impatrq/REDUX/Estructura/Soporte de pantalla/Vista_Isometrica.PNG

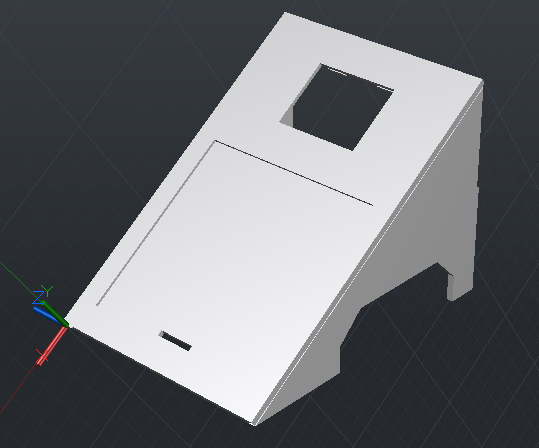
Estructura/Soporte de pantalla/Vista_Isometrica.PNG
