impatrq/REDUX/Kicad/Versión_1/README.md

Primer diseño de kicad de la amplificación y los filtros para sEMG.
