impatrq/REDUX/Circuitos/Filtros_EMG/High_Pass_20Hz/README.md

Diagrama de Bode y archivo LTSpice del filtro pasa-altos con una frecuencia de corte aproximada de 500Hz
