impatrq/REDUX/Circuitos/Filtros_EMG/Low_Pass_500Hz/README.md

Diagrama de Bode y archivo LTSpice del filtro pasa-bajos con una frecuencia de corte aproximada de 500Hz
