impatrq/REDUX/Circuitos/Rectificador_de_Precision/README.md

Se adjuntan los esquemticos del rectificador de precision junto a su simulacion en LTspice
