impatrq/REDUX/Circuitos/Filtros_EMG/High_Pass_20Hz/High_Pass_Wizard.png

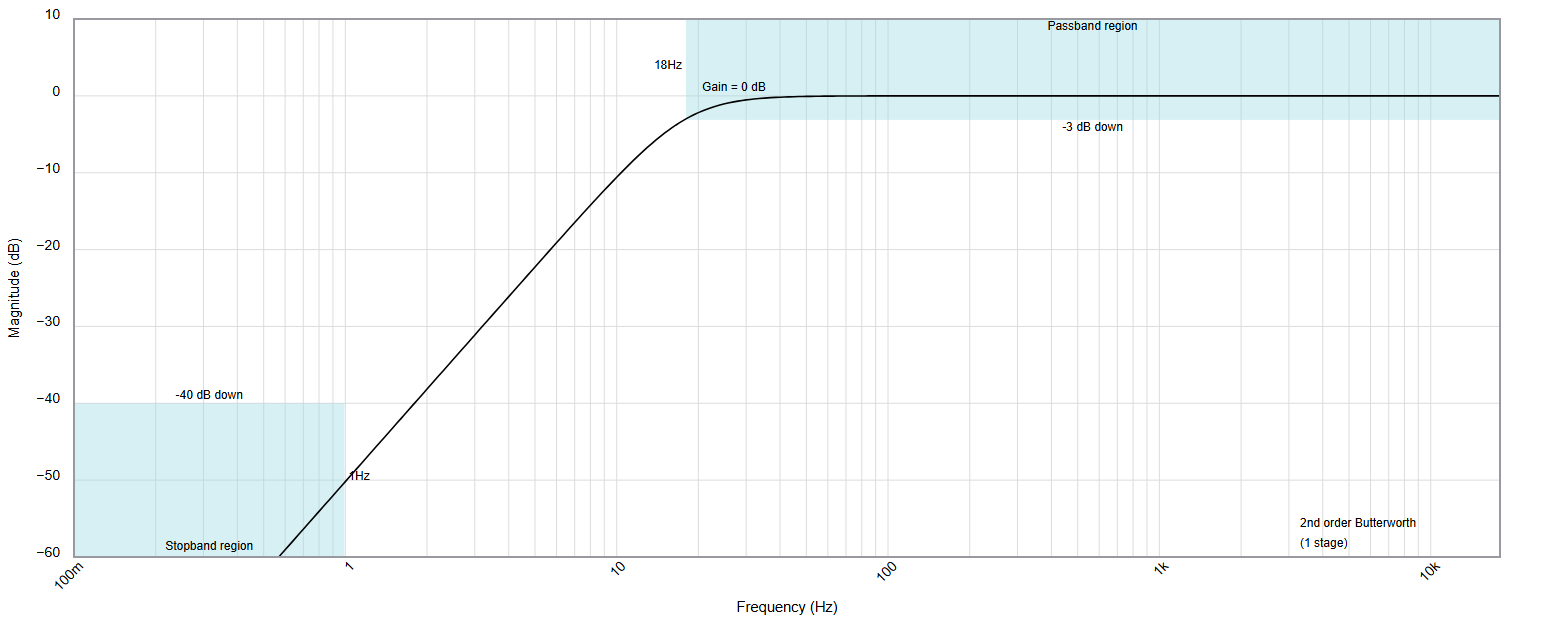
Circuitos/Filtros_EMG/High_Pass_20Hz/High_Pass_Wizard.png
