impatrq/REDUX/Circuitos/Filtros_EMG/High_Pass_20Hz/High_Pass_Zoom_LTSpice.png

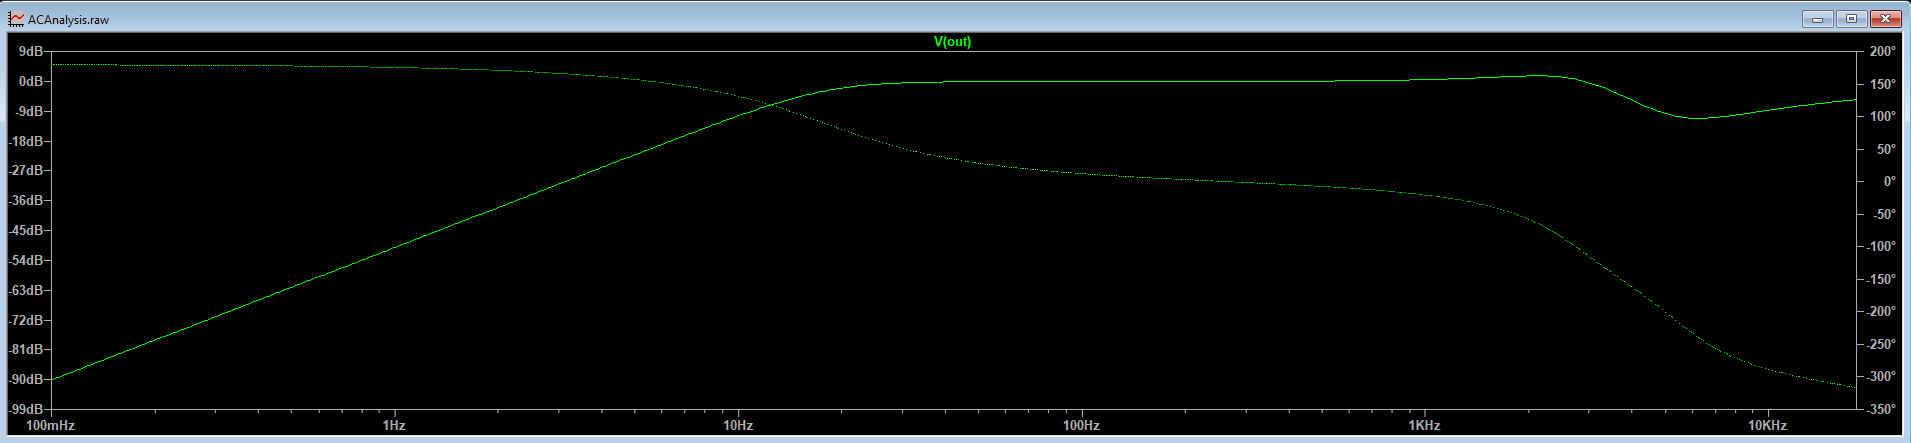
Circuitos/Filtros_EMG/High_Pass_20Hz/High_Pass_Zoom_LTSpice.png
