impatrq/REDUX/Circuitos/Filtros_EMG/Low_Pass_500Hz/Low_Pass_Wizard.png

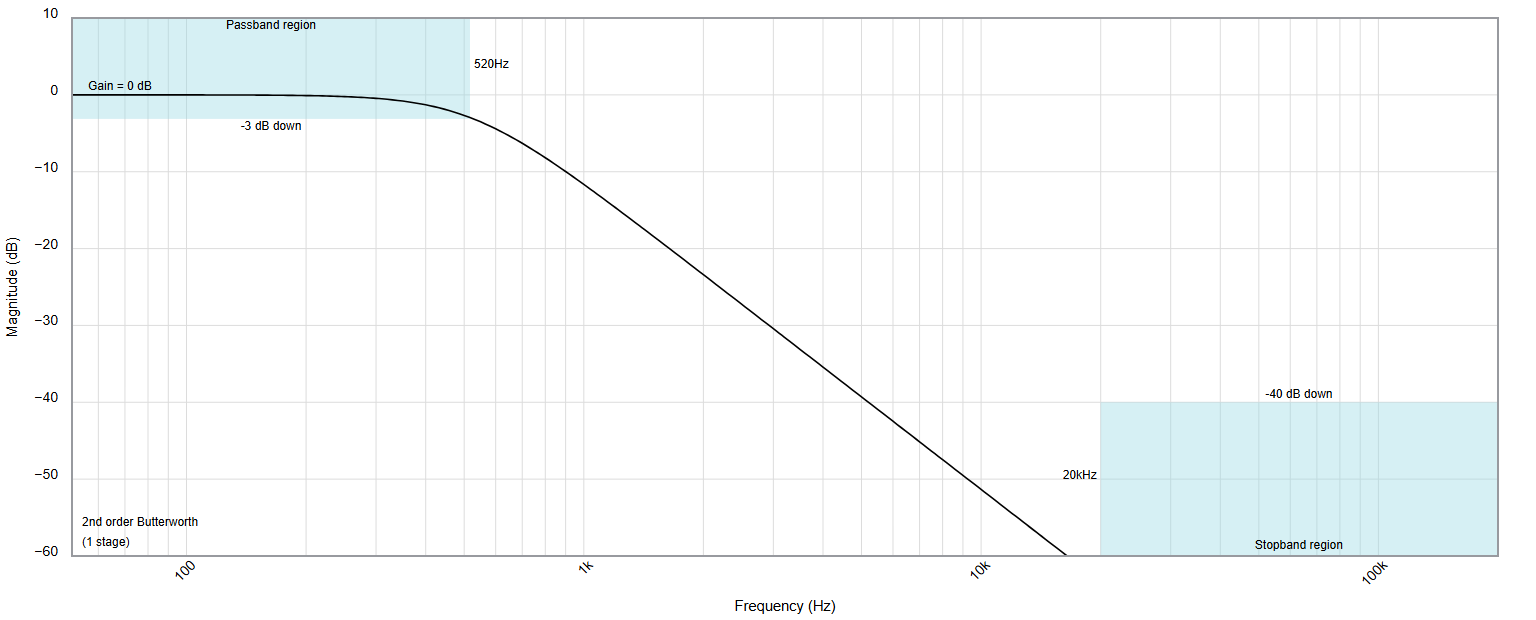
Circuitos/Filtros_EMG/Low_Pass_500Hz/Low_Pass_Wizard.png
