impatrq/REDUX/Circuitos/Filtros_EMG/Low_Pass_500Hz/Low_Pass_Zoom_LTSpice.png

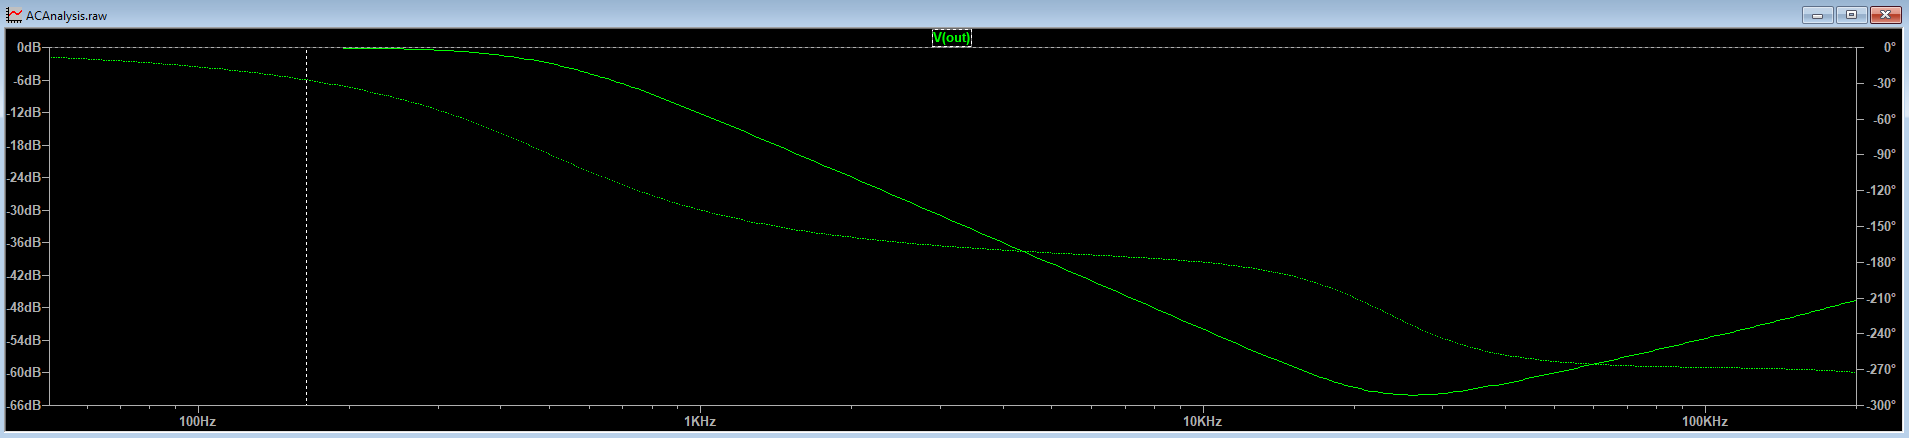
Circuitos/Filtros_EMG/Low_Pass_500Hz/Low_Pass_Zoom_LTSpice.png
