impatrq/REDUX/Circuitos/Rectificador_de_Precision/Onda-completa.png

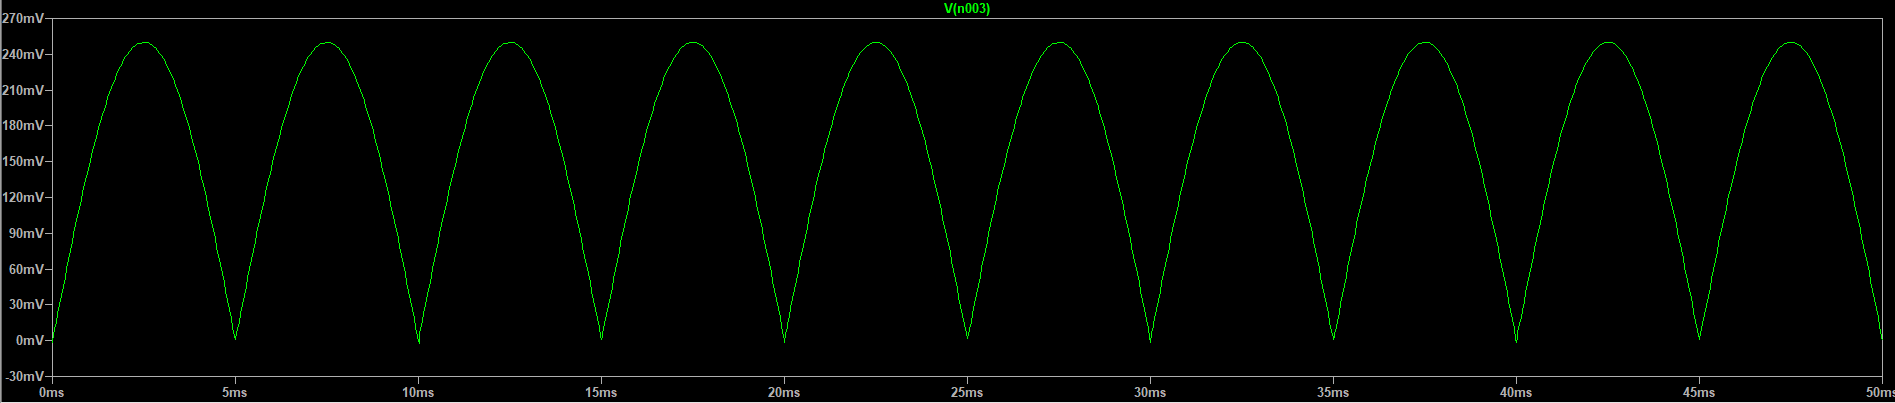
Circuitos/Rectificador_de_Precision/Onda-completa.png
