impatrq/REDUX/Circuitos/Rectificador_de_Precision/Rectificador-de-Precision.png

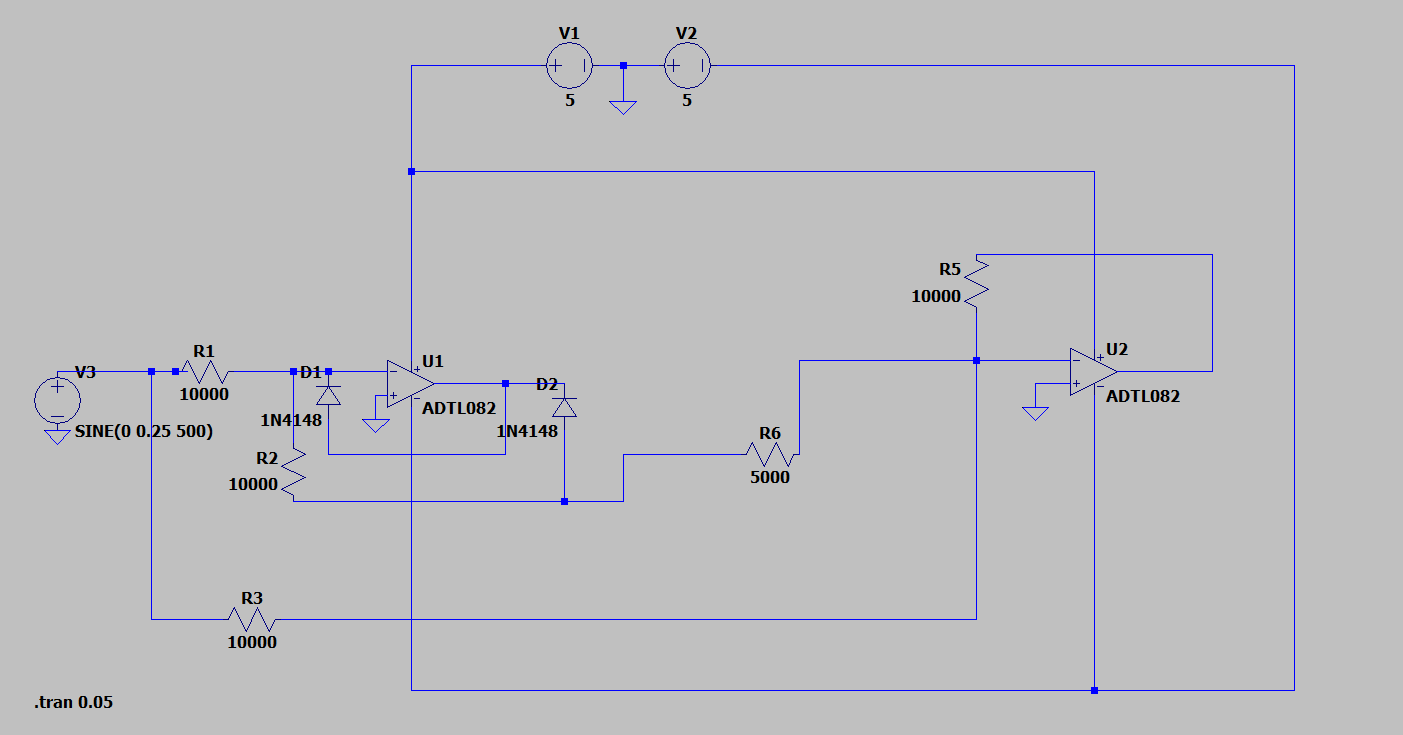
Circuitos/Rectificador_de_Precision/Rectificador-de-Precision.png
