impatrq/REDUX/Docs/AMEF.jpeg

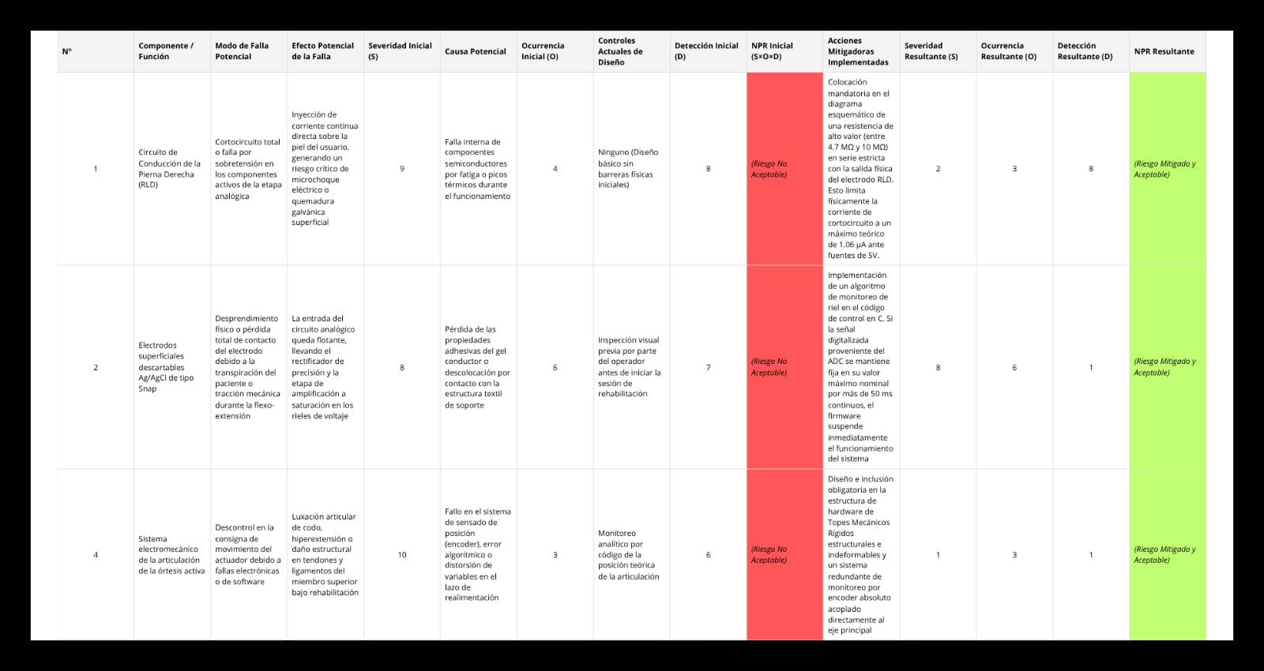
Docs/AMEF.jpeg
