impatrq/REDUX/Estructura/Sorporte de motor/Vista_Isometrica.PNG

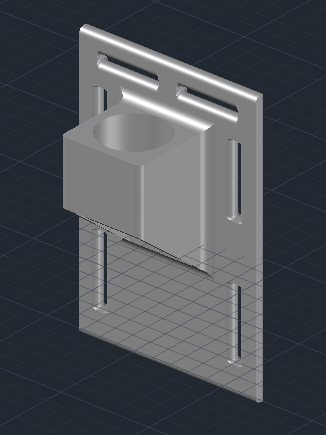
Estructura/Sorporte de motor/Vista_Isometrica.PNG
