impatrq/REDUX/Estructura/Vista_isometrica.png

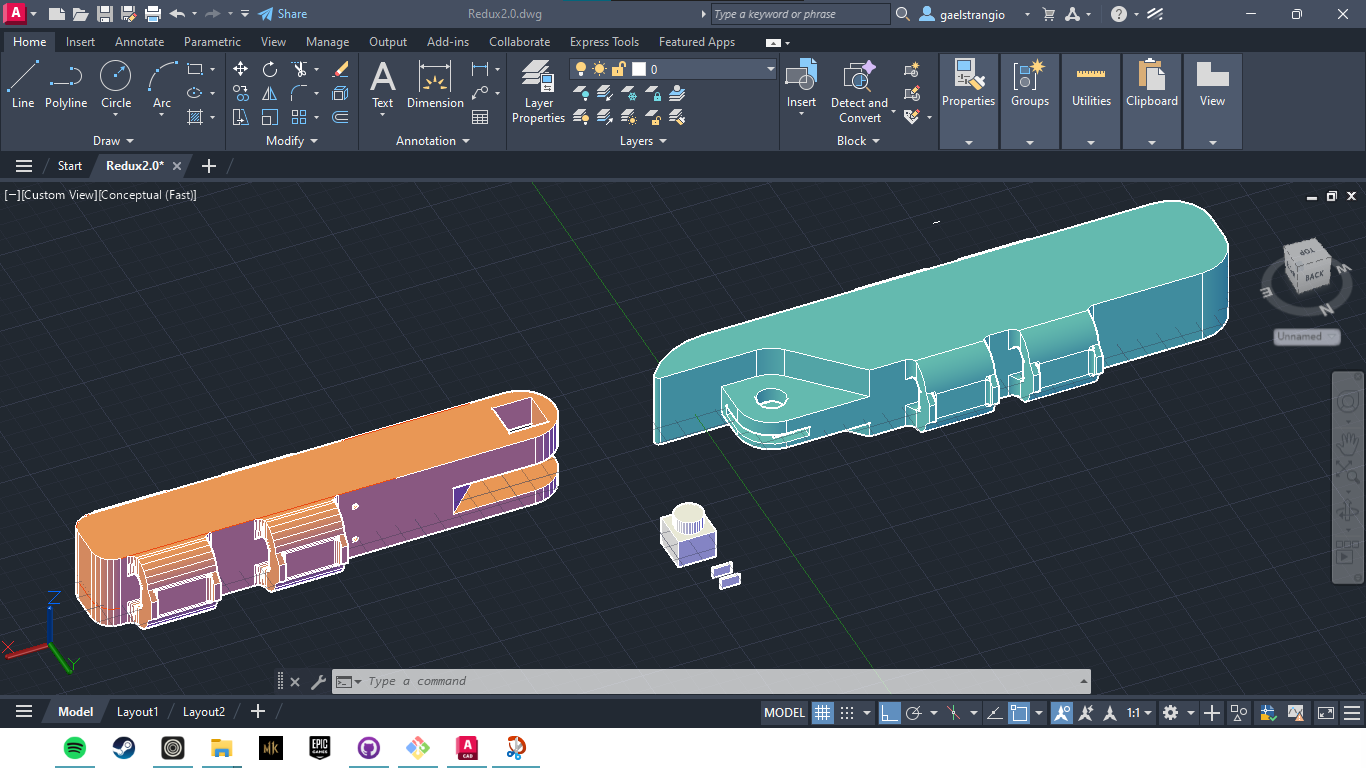
Estructura/Vista_isometrica.png
