impatrq/REDUX/Kicad/Versión_1/Diseño_3D.png

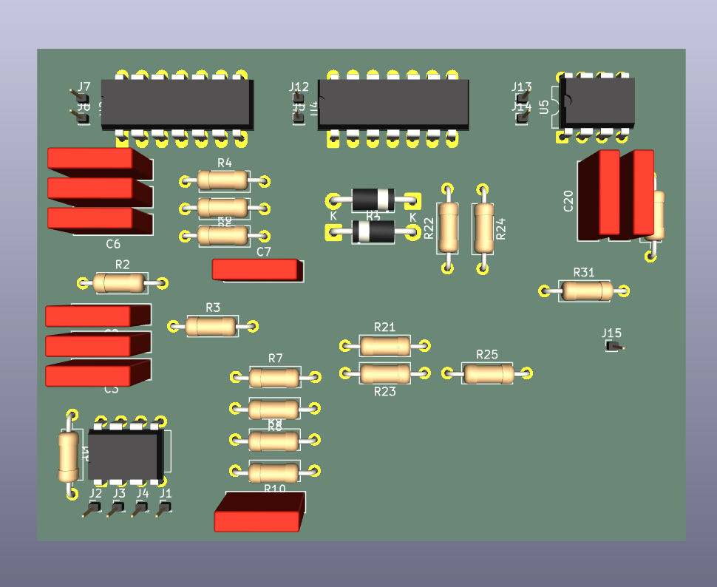
Kicad/Versión_1/Diseño_3D.png
