impatrq/REDUX/Kicad/Versión_1/Editor_de_placa.png

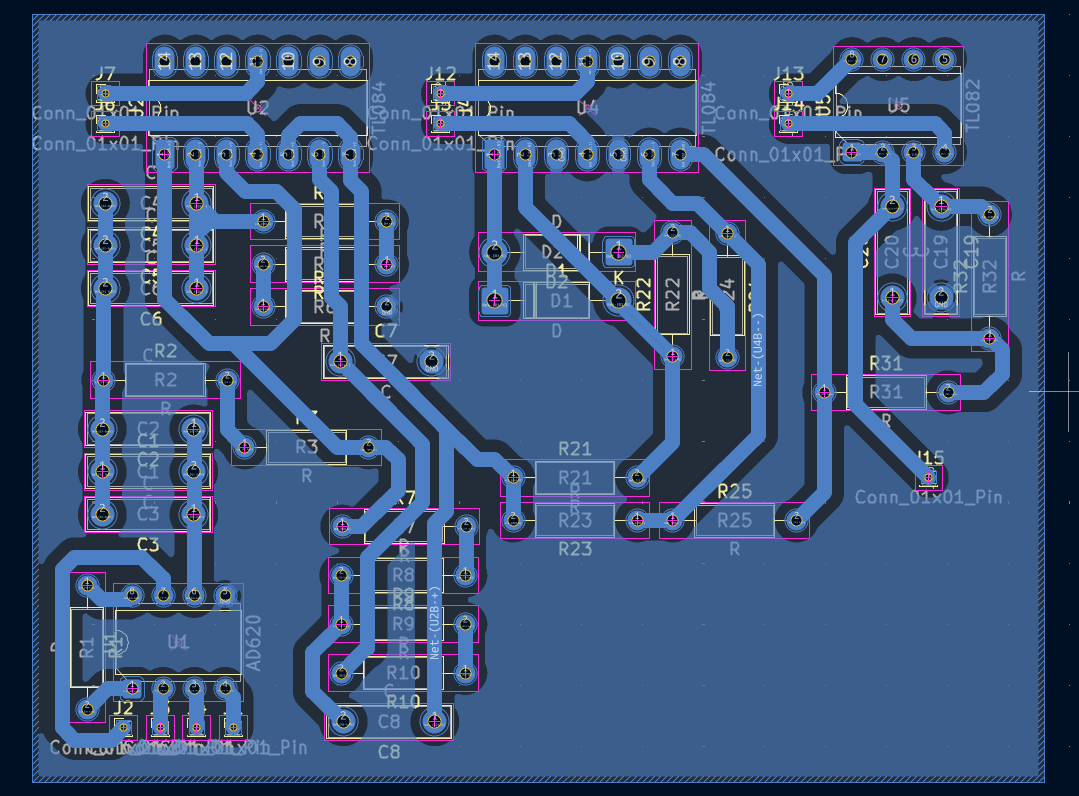
Kicad/Versión_1/Editor_de_placa.png
