impatrq/REDUX/Kicad/Versión_1/Filtro pasabajos.png

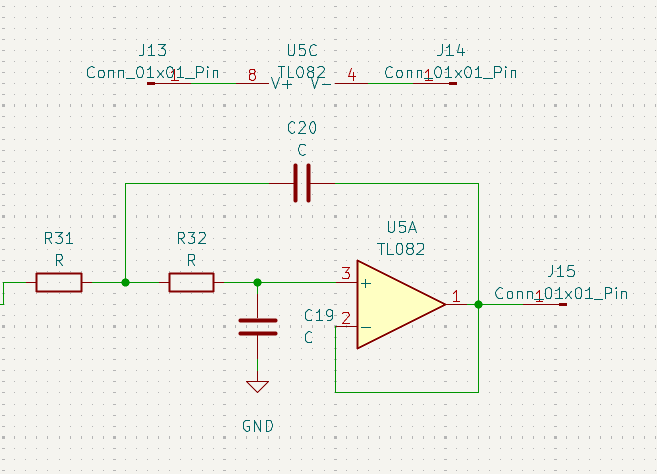
Kicad/Versión_1/Filtro pasabajos.png
