impatrq/REDUX/Kicad/Versión_1/Filtro pasabanda.png

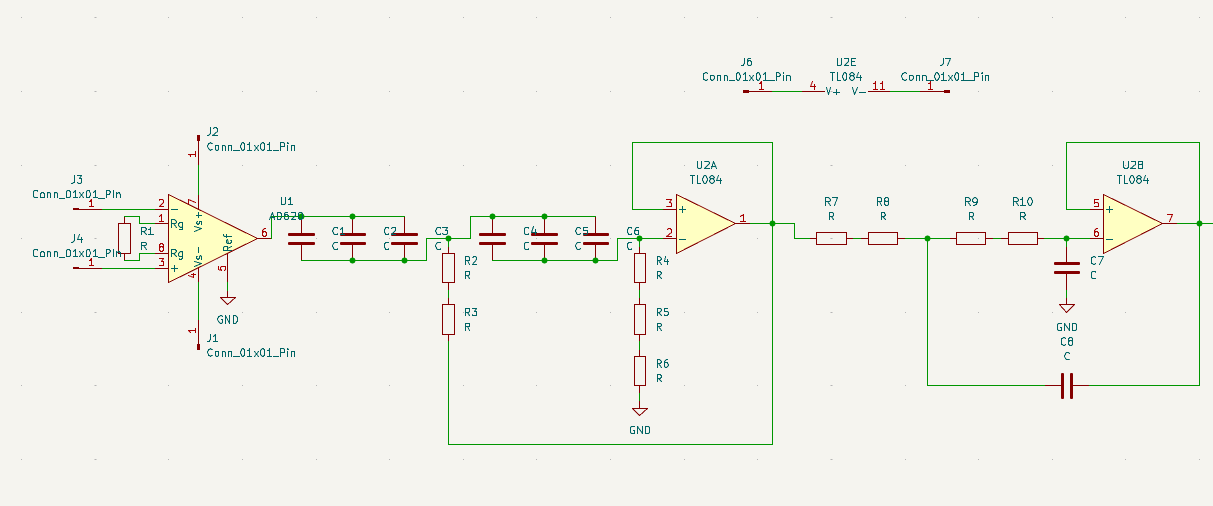
Kicad/Versión_1/Filtro pasabanda.png
