impatrq/REDUX/Kicad/Versión_1/Rectificador de precision.png

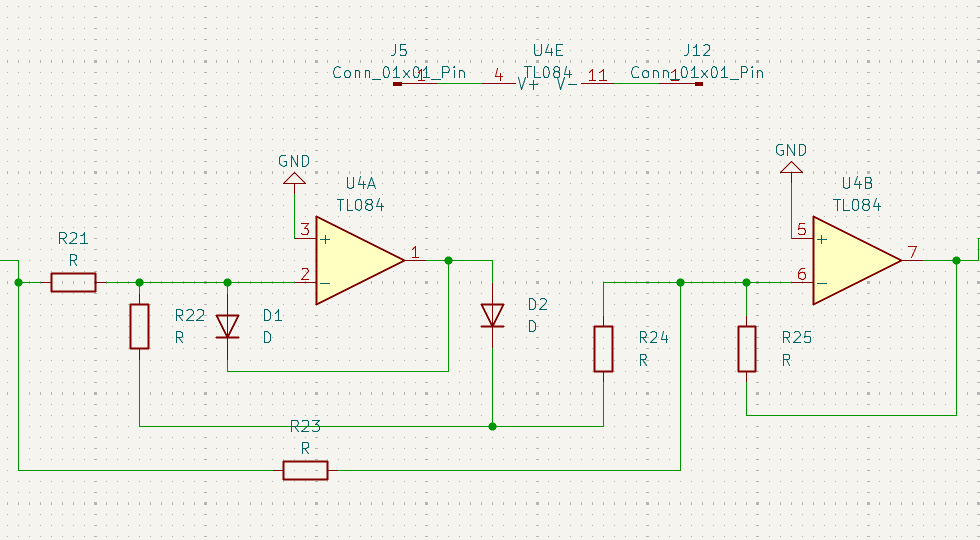
Kicad/Versión_1/Rectificador de precision.png
