impatrq/REDUX/Kicad/Versión_2/Etapa de filtro pasabajos/Etapa de filtro pasabajos_pcb.png

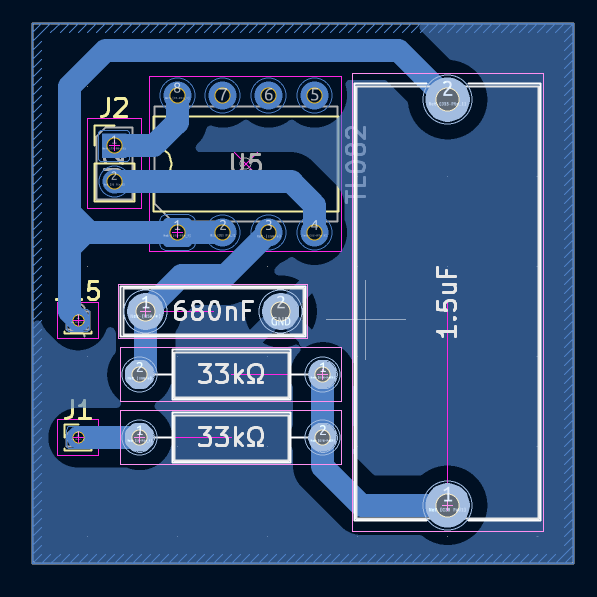
Kicad/Versión_2/Etapa de filtro pasabajos/Etapa de filtro pasabajos_pcb.png
