impatrq/REDUX/Kicad/Versión_2/Etapa de filtro pasabanda/Etapa de filtro pasabanda — Editor de placas 28_08_2026 14_08_09.png

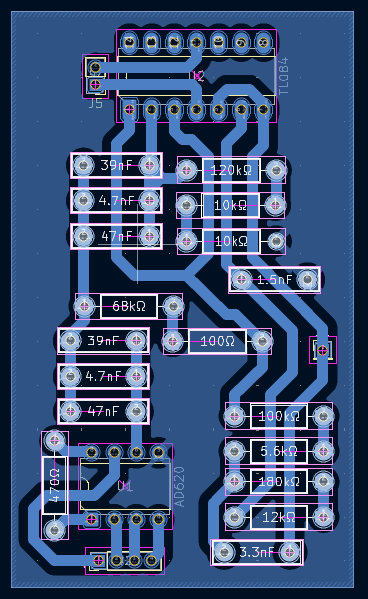
Kicad/Versión_2/Etapa de filtro pasabanda/Etapa de filtro pasabanda — Editor de placas 28_08_2026 14_08_09.png
