impatrq/REDUX/Kicad/Versión_2/Etapa de rectificación de presición/Etapa de rectificación de presición_pcb.png

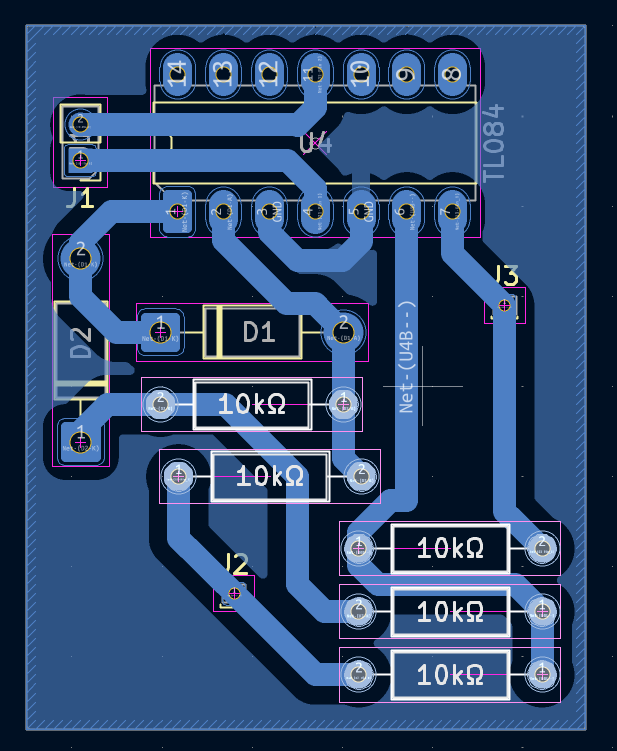
Kicad/Versión_2/Etapa de rectificación de presición/Etapa de rectificación de presición_pcb.png
