impatrq/REDUX/modelo_preeliminar/Vista_Frontal.png

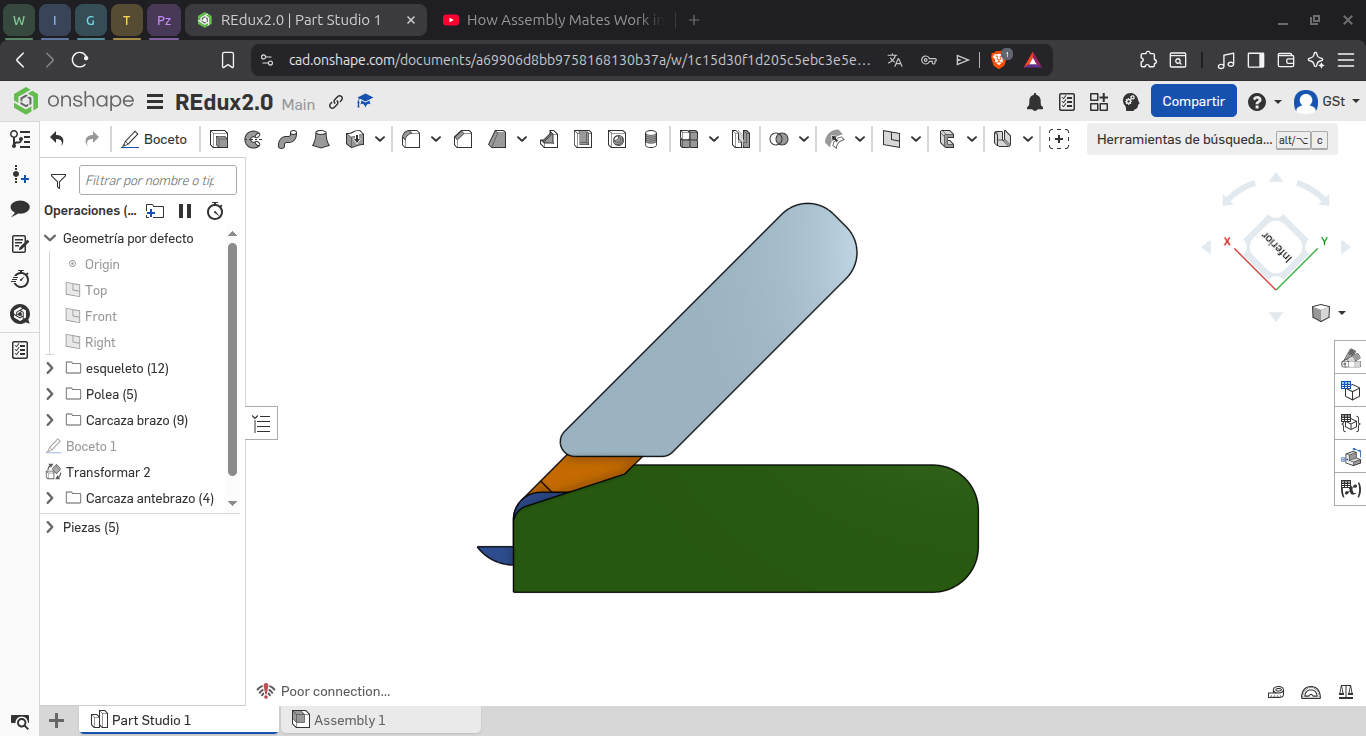
modelo_preeliminar/Vista_Frontal.png
