impatrq/REDUX/modelo_preeliminar/Vista_Isometrica.png

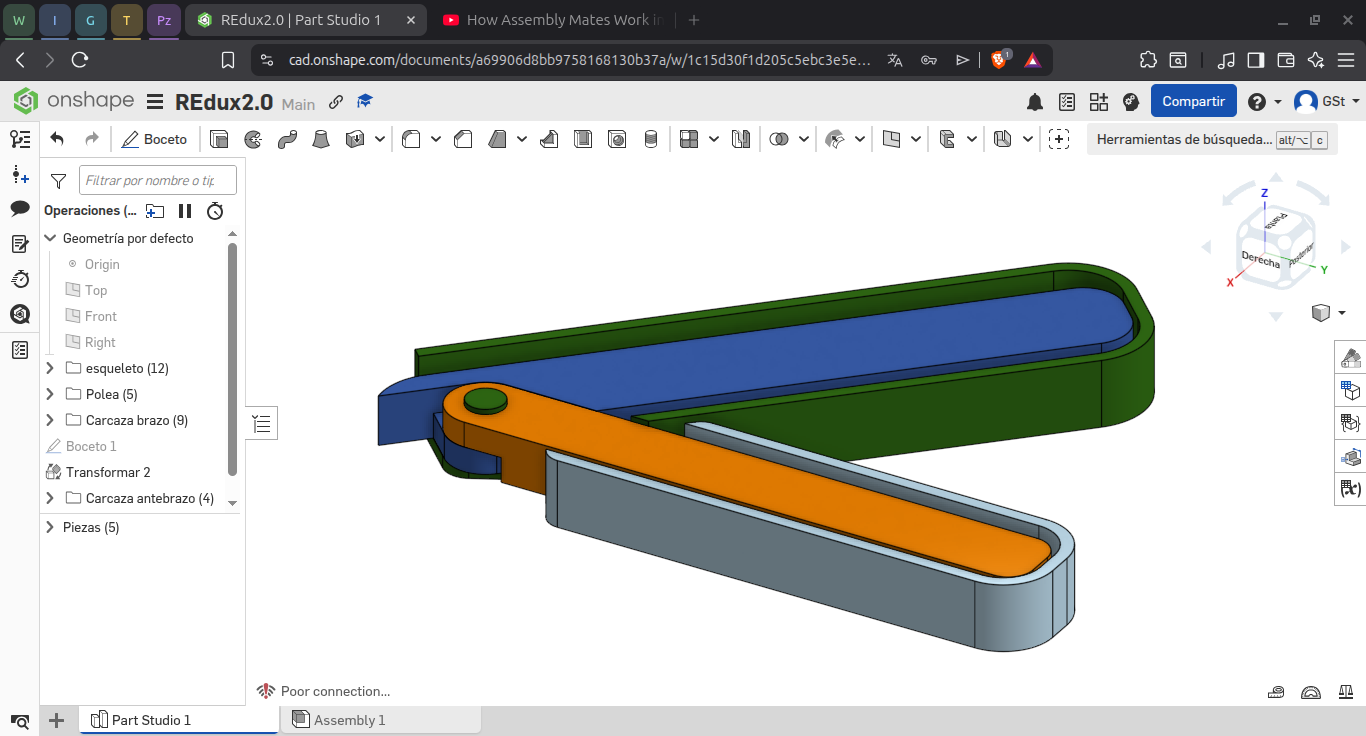
modelo_preeliminar/Vista_Isometrica.png
