impatrq/REDUX/modelo_preeliminar/Vista_Posterior.png

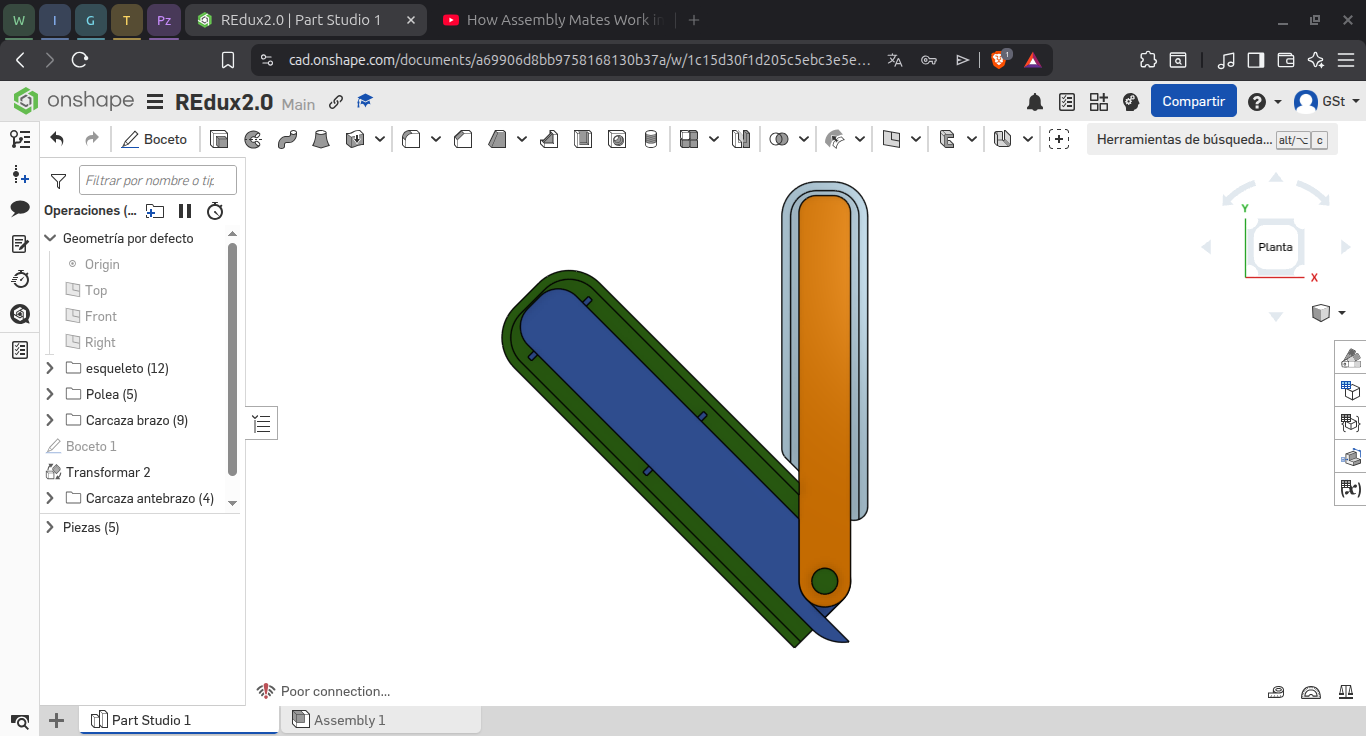
modelo_preeliminar/Vista_Posterior.png
