impatrq/REDUX/Estructura/Caja/tapa.stl

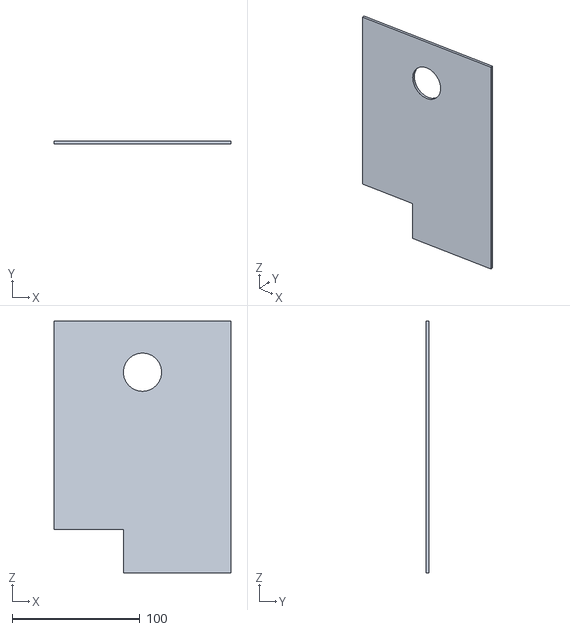
[picture p25: CAD file, 2026-11-13]
Estructura/Caja/tapa.stl
138.0 x 2.30 x 197.0
