impatrq/REDUX/Estructura/Redux_''final''_eje.stl

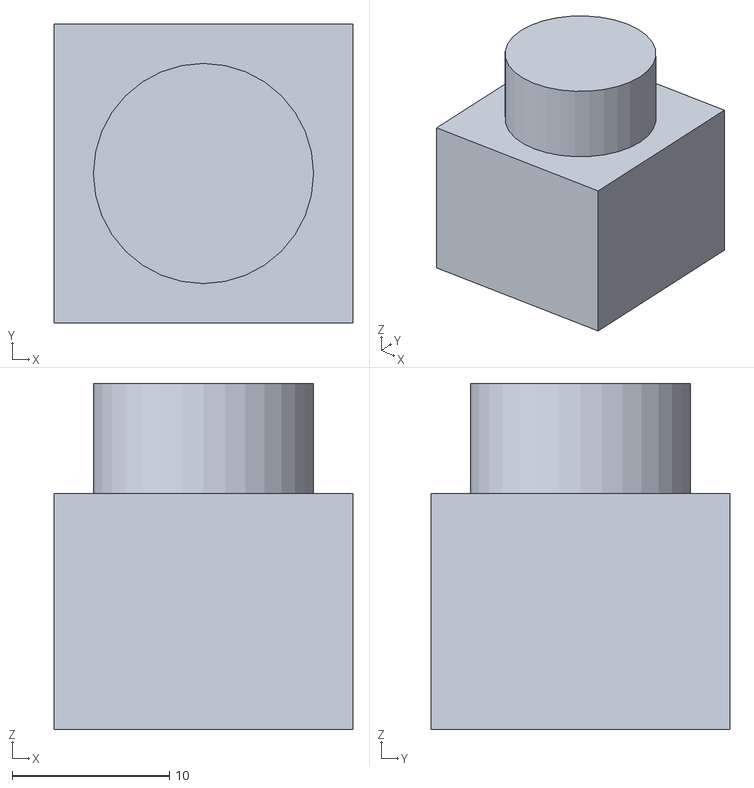
[picture p26: CAD file, 2026-08-31]
Estructura/Redux_''final''_eje.stl
19.0 x 19.0 x 22.0
