impatrq/REDUX/Estructura/Soporte de pantalla/Soporte_pantalla.stl

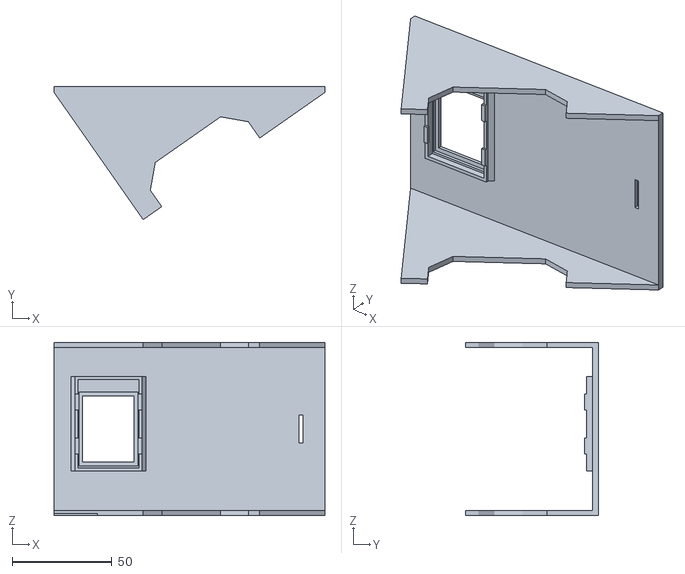
[picture p27: CAD file, 2026-10-20]
Estructura/Soporte de pantalla/Soporte_pantalla.stl
136.0 x 66.9 x 87.0
