impatrq/REDUX/Estructura/Sorporte de motor/soporte_final.stl

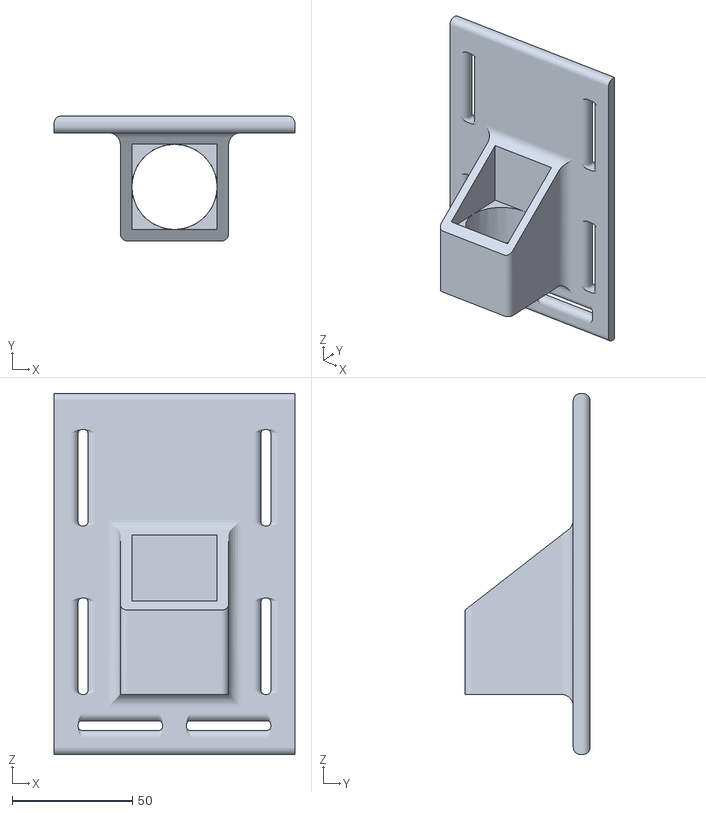
[picture p28: CAD file, 2026-11-13]
Estructura/Sorporte de motor/soporte_final.stl
100.0 x 52.0 x 150.0
