impatrq/REDUX/Estructura/Redux_''final''_Antebrazo.stl

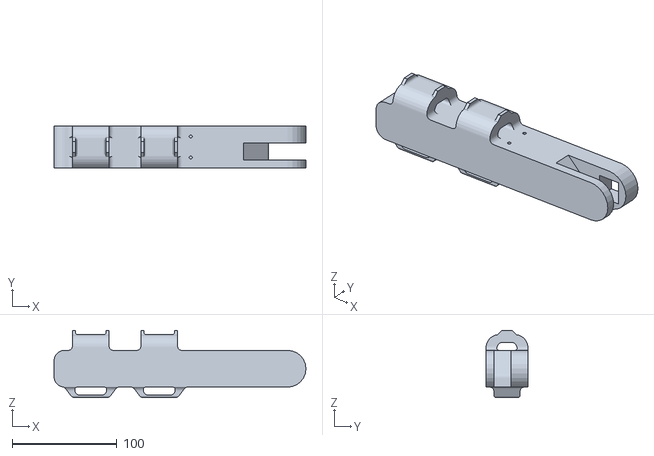
[picture p29: CAD file, 2026-08-31]
Estructura/Redux_''final''_Antebrazo.stl
240.0 x 40.0 x 64.0
