impatrq/REDUX/Estructura/Sorporte de motor/Soporte_motor.stl

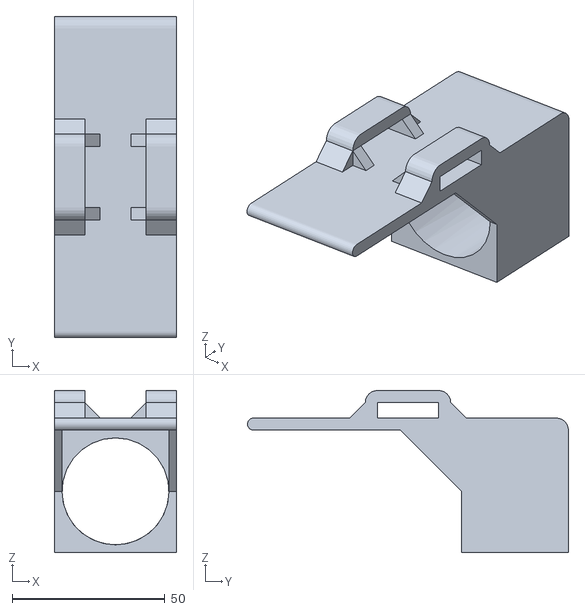
[picture p30: CAD file, 2026-10-02]
Estructura/Sorporte de motor/Soporte_motor.stl
40.0 x 105.0 x 53.0
