impatrq/REDUX/Estructura/Redux_''final''_Pestañas_de_soporte.stl

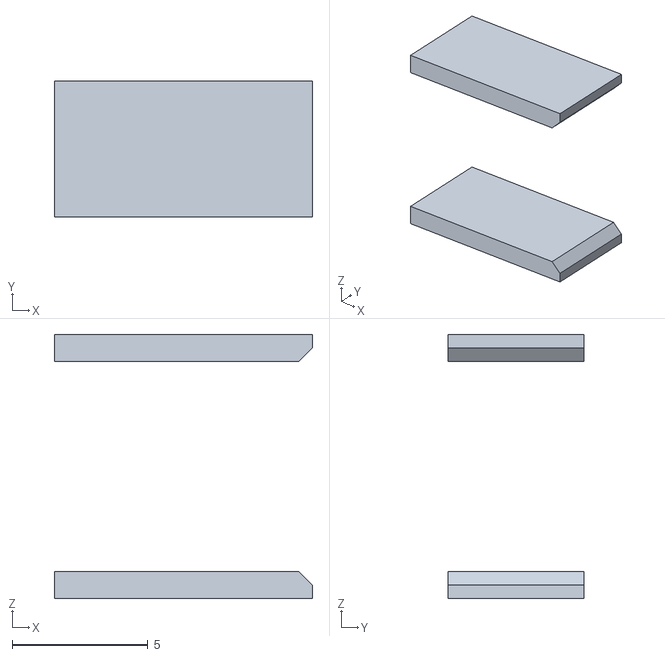
[picture p31: CAD file, 2026-08-31]
Estructura/Redux_''final''_Pestañas_de_soporte.stl
9.50 x 5.00 x 9.74
