impatrq/REDUX/Estructura/Redux_''final''_Brazo.stl

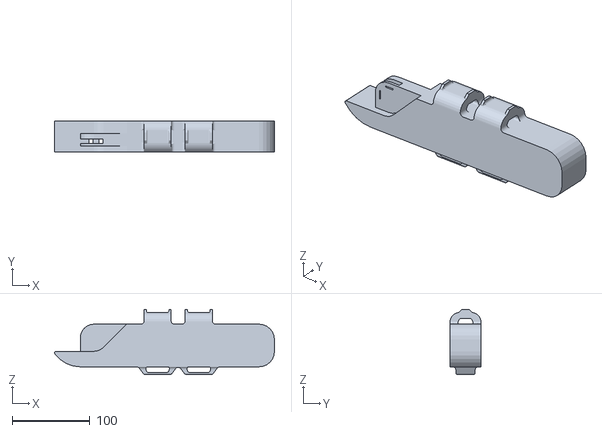
[picture p32: CAD file, 2026-08-31]
Estructura/Redux_''final''_Brazo.stl
283.3 x 40.0 x 84.0
