impatrq/REDUX/(list of files, cad)

Other CAD files:
Estructura/Sorporte de motor/Soporte_motor.dwg
