impatrq/REDUX/Circuitos/Rectificador_de_Precision/rectificador.asc

D1: diode; 1N4148
D2: diode; 1N4148
R1: res; 10000
R2: res; 10000
R3: res; 10000
R5: res; 10000
R6: res; 5000
U1: ADTL082
U2: ADTL082
V1: voltage; 5
V2: voltage; 5
V3: voltage; SINE(0 1 100)
Named nets: 0
.tran 0.05
