impatrq/REDUX/Circuitos/Filtros_EMG/High_Pass_20Hz/LTspice_HighPass/ACAnalysis.asc

STAGE1: StageA_HighPassSallenKey_LT6004
V1: voltage; 0
V2: voltage; 5
V3: voltage; -5
VIN: voltage; SINE(0 16.1m 100m); AC 1
Named nets: 0, Vp, Vn, OUT, Vref, IN
.AC DEC 100 100m 18k 
.save V(*?*) I(*?*)
If you're having trouble with simulation try the following:
 
- Ensure that LTspice circuit folder is unzipped.  LTspice won't 
be able to locate subcircuits if the folders are still zipped.
 
- Update LTspice - devices that have been recently added to LTspice
won't be available unless you update by clicking Tools -> Sync Release.
