impatrq/REDUX/Circuitos/Filtros_EMG/High_Pass_20Hz/LTspice_HighPass/StageA_HighPassSallenKey_LT6004.asc

C1: cap; 91n
C2: cap; 91n
R1: res; 68.1k
R2: res; 140k
U1: LT6004
Named nets: V+, V-, OUT, IN, REF
This subcircuit is not simulatable.  
Please open one of the 
"Filter Design*.asc" schematics to 
simulate your Filter Wizard design.
