impatrq/REDUX/Circuitos/Filtros_EMG/Low_Pass_500Hz/LTspice_LowPass/NoiseAnalysis.asc

STAGE1: StageA_LowPassSallenKey_ADA4096
V1: voltage; 0
V2: voltage; 5
V3: voltage; -5
VNOISE: voltage; SINE(0 4.94 50); AC 1
Named nets: 0, Vp, Vn, OUT, Vref, IN
.NOISE V(OUT) VNOISE DEC 100 50.5 200k 
.save V(*?*) I(*?*)
If you're having trouble with simulation try the following:
 
- Ensure that LTspice circuit folder is unzipped.  LTspice won't 
be able to locate subcircuits if the folders are still zipped.
 
- Update LTspice - devices that have been recently added to LTspice
won't be available unless you update by clicking Tools -> Sync Release.
