impatrq/REDUX/Circuitos/Filtros_EMG/Low_Pass_500Hz/LTspice_LowPass/StageA_LowPassSallenKey_ADA4096.asc

C1: cap; 3.3n
C2: cap; 1.5n
R1: res; 105k
R2: res; 191k
U1: ADA4096
Named nets: V+, V-, OUT, IN, REF
This subcircuit is not simulatable.  
Please open one of the 
"Filter Design*.asc" schematics to 
simulate your Filter Wizard design.
