impatrq/REDUX/Kicad/Versión_4/Unión final.kicad_pcb

## KiCad design Kicad/Versión_4/Unión final.kicad_pcb (2026-11-05)

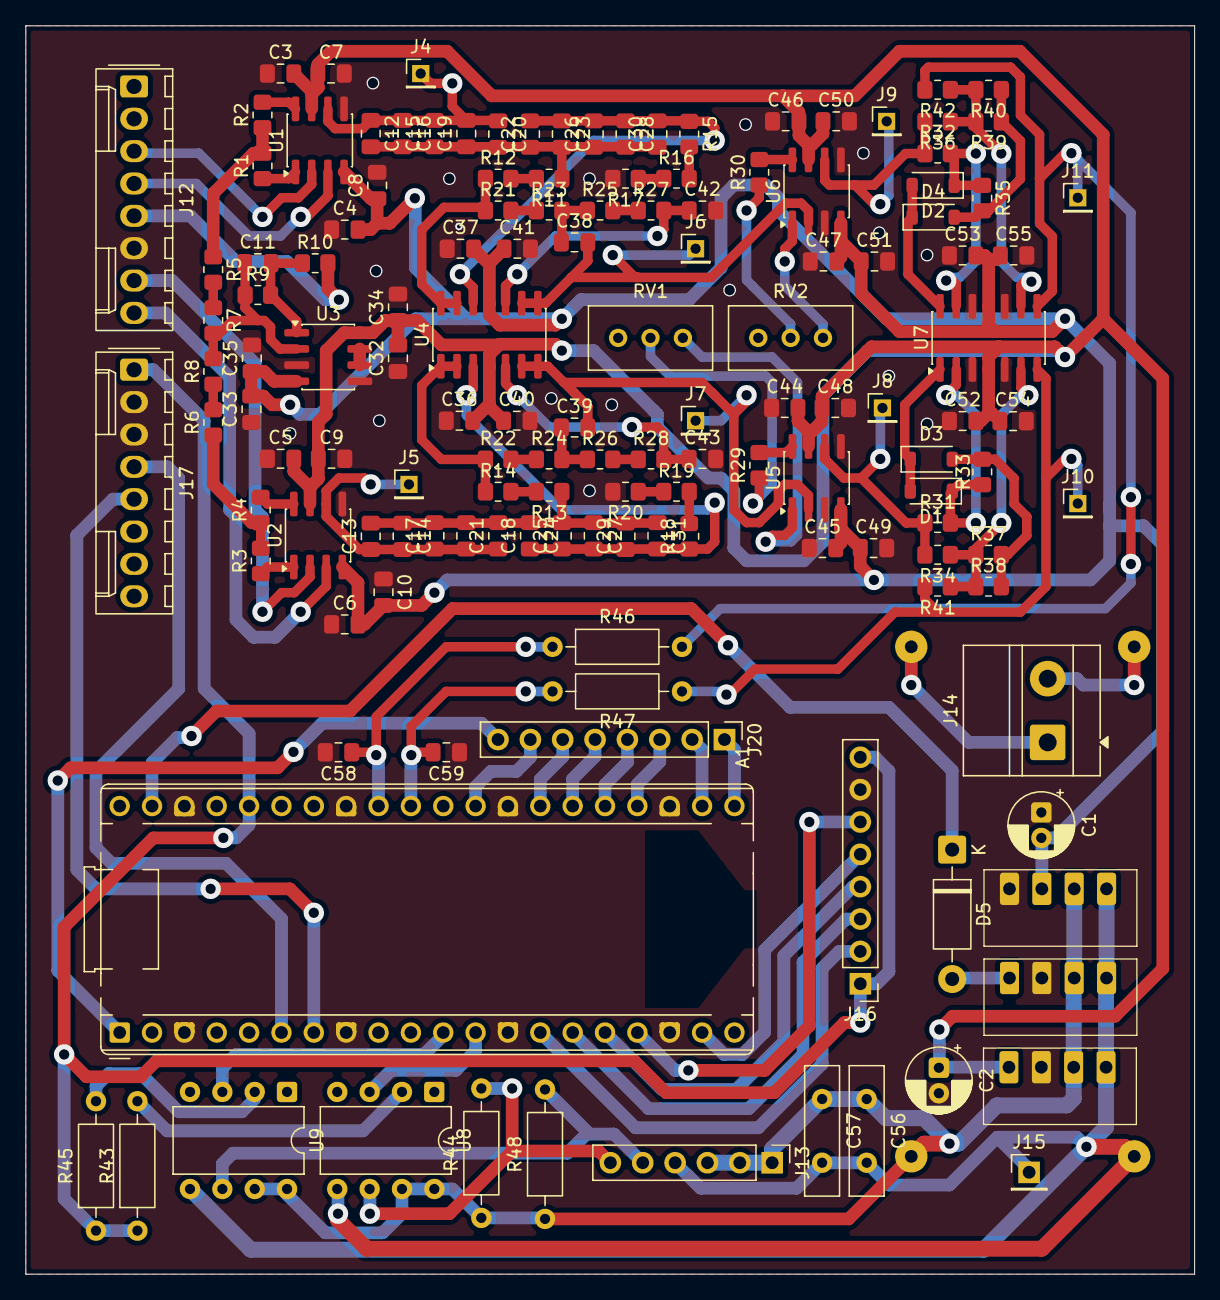
[picture p33: board Unión final.kicad_pcb from above]

Board: 2 copper layers, 91.8 x 98.0 mm, 143 parts (1 on the bottom side), 91 nets.

Parts:
A1: RaspberryPi_Pico_W; RaspberryPi_Pico_Common_THT
B1, B2, B3: B0505s; B0505S-1w
C1, C2: 10u_Pol; CP_Radial_D5.0mm_P2.00mm
C3, C4, C5, C6, C32, C33, C36, C37, C44, C45, C46, C47, C52, C53, C58, C59: 100n; C_0805_2012Metric_Pad1.18x1.45mm_HandSolder
C7, C8, C9, C10, C34, C35, C40, C41, C48, C49, C50, C51, C54, C55: 10u; C_0805_2012Metric_Pad1.18x1.45mm_HandSolder
C11: 10n; C_0805_2012Metric_Pad1.18x1.45mm_HandSolder
C12, C13, C22, C24: 33nf; C_0805_2012Metric_Pad1.18x1.45mm_HandSolder
C14, C15, C18, C19, C23, C25, C28, C29, C38, C39: 3.3nf; C_0805_2012Metric_Pad1.18x1.45mm_HandSolder
C16, C17, C26, C27: 4.7nf; C_0805_2012Metric_Pad1.18x1.45mm_HandSolder
C20, C21, C30, C31: 47nf; C_0805_2012Metric_Pad1.18x1.45mm_HandSolder
C42, C43: 1.5nF; C_0805_2012Metric_Pad1.18x1.45mm_HandSolder
C56, C57: 100nf; C_Disc_D10.0mm_W2.5mm_P5.00mm
D1, D2, D3, D4: 1N4148; D_SOD-123
D5: D_Schottky; D_DO-41_SOD81_P10.16mm_Horizontal
J4: Amp out; PinHeader_1x01_P2.00mm_Vertical
J5: Amp1 biceps out; PinHeader_1x01_P2.00mm_Vertical
J6: Filtro_PB out; PinHeader_1x01_P2.00mm_Vertical
J7: Filtro_PB biceps out; PinHeader_1x01_P2.00mm_Vertical
J8: Amp2 biceps out; PinHeader_1x01_P2.00mm_Vertical
J9: Amp2 out; PinHeader_1x01_P2.00mm_Vertical
J10: Rectificador biceps out; PinHeader_1x01_P2.00mm_Vertical
J11: Rectificador out; PinHeader_1x01_P2.00mm_Vertical
J12: Molex brazo; Molex_KK-254_AE-6410-08A_1x08_P2.54mm_Vertical
J13: Driver; PinHeader_1x06_P2.54mm_Vertical
J14: +-12V; TerminalBlock_MetzConnect_Type011_RT05502HBLC_1x02_P5.00mm_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
J15: Conn_01x01_Pin; PinHeader_1x01_P2.54mm_Vertical
J16: TFT; PinHeader_1x08_P2.54mm_Vertical
J17: Encoder; Molex_KK-254_AE-6410-08A_1x08_P2.54mm_Vertical
J20: Teclado 4x4; PinHeader_1x08_P2.54mm_Vertical
LM1: LM2596
R1, R3: 2.7KΩ; R_0805_2012Metric_Pad1.20x1.40mm_HandSolder
R2, R4: 2.7kΩ; R_0805_2012Metric_Pad1.20x1.40mm_HandSolder
R5, R6, R7, R8, R16, R17, R19, R20, R31, R32, R33, R34, R35, R36, R37, R38, R39, R40, R41, R42: 10KΩ; R_0805_2012Metric_Pad1.20x1.40mm_HandSolder
R9: 1MΩ; R_0805_2012Metric_Pad1.20x1.40mm_HandSolder
R10: 470kΩ; R_0805_2012Metric_Pad1.20x1.40mm_HandSolder
R11, R13: 68KΩ; R_0805_2012Metric_Pad1.20x1.40mm_HandSolder
R12, R14: 100Ω; R_0805_2012Metric_Pad1.20x1.40mm_HandSolder
R15, R18: 120KΩ; R_0805_2012Metric_Pad1.20x1.40mm_HandSolder
R21, R22: 100KΩ; R_0805_2012Metric_Pad1.20x1.40mm_HandSolder
R23, R24: 5K6Ω; R_0805_2012Metric_Pad1.20x1.40mm_HandSolder
R25, R26: 180KΩ; R_0805_2012Metric_Pad1.20x1.40mm_HandSolder
R27, R28: 12KΩ; R_0805_2012Metric_Pad1.20x1.40mm_HandSolder
R29, R30: 470Ω; R_0805_2012Metric_Pad1.20x1.40mm_HandSolder
R43, R45: 220; R_Axial_DIN0207_L6.3mm_D2.5mm_P10.16mm_Horizontal
R44, R48: 10k; R_Axial_DIN0207_L6.3mm_D2.5mm_P10.16mm_Horizontal
R46, R47: 2k2; R_Axial_DIN0207_L6.3mm_D2.5mm_P10.16mm_Horizontal
RV1, RV2: R_Potentiometer_Trim; Potentiometer_Bourns_3296W_Vertical
U1, U2, U5, U6: AD620; SOIC-8_3.9x4.9mm_P1.27mm
U3: TL072; SOIC-8_3.9x4.9mm_P1.27mm
U4, U7: TL084; SOIC-14_3.9x8.7mm_P1.27mm
U8, U9: 6N137; DIP-8_W7.62mm

Connections:
3V3 Out: A1.36 (3V3), J16.1, J16.8, J17.1, R43.1, R45.1
+5V: B1.4, C2.1, C3.2, C5.2, C7.1, C9.1, C32.2, C34.1, C36.2, C40.1, C44.2, C46.2, C48.1, C50.1, C52.2, C54.1, U1.7 (Vs+), U2.7 (Vs+), U3.8 (V+), U4.4 (V+), U5.7 (Vs+), U6.7 (Vs+), U7.4 (V+)
-5V: B2.3, C1.2, C4.2, C6.2, C8.1, C10.2, C33.2, C35.1, C37.2, C41.1, C45.2, C47.2, C49.1, C51.1, C53.2, C55.1, U1.4 (Vs-), U2.4 (Vs-), U3.4 (V-), U4.11 (V-), U5.4 (Vs-), U6.4 (Vs-), U7.11 (V-)
A0 TFT: A1.16 (GPIO12), J16.4
A Left: R43.2, U8.2 (A)
A Right: R45.2, U9.2 (A)
Amp1 biceps: C13.1, C14.2, C17.1, C18.2, C21.1, J5.1 (Pin_1_1), U2.6
Amp1 triceps: C12.1, C15.2, C16.1, C19.2, C20.1, J4.1 (Pin_1_1), U1.6
Amp2 biceps: J8.1 (Pin_1_1), R31.1, R34.2, U5.6
Amp2 triceps: J9.1 (Pin_1_1), R32.1, R36.2, U6.6
CMRR biceps: R3.2, R4.1, R6.1
CMRR triceps: R1.2, R2.1, R5.1
CS TFT: A1.17 (GPIO13), J16.6
Filtro_PB biceps: C39.2, J7.1 (Pin_1_1), U4.6 (-), U4.7, U5.2 (-)
Filtro_PB triceps: C38.2, J6.1 (Pin_1_1), U4.8, U4.9 (-), U6.2 (-)
GND: A1.3 (GND), A1.8 (GND), A1.13 (GND), A1.18 (GND), A1.23 (GND), A1.28 (GND), A1.33 (AGND), A1.38 (GND), B1.3, B2.4, B3.3, C1.1, C2.2, C3.1, C4.1, C5.1, C6.1, C7.2, C8.2, C9.2, C10.1, C32.1, C33.1, C34.2, C35.2, C36.1, C37.1, C40.2, C41.2, C42.2, C43.2, C44.1, C45.1, C46.1, C47.1, C48.2, C49.2, C50.2, C51.2, C52.1, C53.1, C54.2, C55.2, C58.2, C59.1, J12.6, J16.7, J17.2, J17.3, R17.2, R20.2, U1.5 (Ref), U2.5 (Ref), U3.3 (+), U3.5 (+), U5.3 (+), U5.5 (Ref), U6.3 (+), U6.5 (Ref), U7.3 (+), U7.5 (+), U7.10 (+), U7.12 (+)
GND 1: B1.1, B2.1, B3.1, C56.2, C57.2, J13.4, J15.1 (Pin_1_1), LM1.1, U8.5 (GND), U9.5 (GND)
In+ LM: J14.1, LM1.3
In+ biceps: J12.7, U2.2 (-)
In+ triceps: J12.3, U1.2 (-)
In- LM: J14.2, LM1.2
In- biceps: J12.8, U2.3 (+)
In- triceps: J12.4, U1.3 (+)
unnamed: A1.31 (GPIO26_ADC0), C59.2, R47.2
unnamed: A1.32 (GPIO27_ADC1), C58.1, R46.1
unnamed: B3.4, D5.2 (A)
unnamed: C11.2, R9.2, R10.1, U3.1
unnamed: C12.2, C15.1, C16.2, C19.1, C20.2, C22.1, C23.2, C26.1, C28.2, C30.1, R11.1
unnamed: C13.2, C14.1, C17.2, C18.1, C21.2, C24.1, C25.2, C27.1, C29.2, C31.1, R13.1
unnamed: C38.1, R23.2, R25.1
unnamed: C39.1, R24.2, R26.1
unnamed: D1.2 (A), D3.1 (K), U7.1
unnamed: D1.1 (K), R31.2, R33.1, U7.2 (-)
unnamed: D2.2 (A), D4.1 (K), U7.14
unnamed: D2.1 (K), R32.2, R35.1, U7.13 (-)
unnamed: D3.2 (A), R33.2, R37.2, R38.2
unnamed: D4.2 (A), R35.2, R39.1, R40.1
unnamed: R1.1, U1.1 (Rg)
unnamed: R2.2, U1.8 (Rg)
unnamed: R3.1, U2.1 (Rg)
unnamed: R4.2, U2.8 (Rg)
unnamed: R5.2, R7.1
unnamed: R6.2, R8.1
unnamed: R11.2, R12.2
unnamed: R13.2, R14.2
unnamed: R15.2, R16.2
unnamed: R16.1, R17.1
unnamed: R18.2, R19.2
unnamed: R19.1, R20.1
unnamed: R21.2, R23.1
unnamed: R22.2, R24.1
unnamed: R25.2, R27.1
unnamed: R26.2, R28.1
unnamed: R29.1, RV1.2
unnamed: R29.2, U5.8 (Rg)
unnamed: R30.1, RV2.2
unnamed: R30.2, U6.8 (Rg)
unnamed: RV1.1, U5.1 (Rg)
unnamed: RV2.1, U6.1 (Rg)
unnamed: C11.1, R7.2, R8.2, R9.1, U3.2 (-)
unnamed: U3.6 (-), U3.7
unnamed: C24.2, C25.1, C27.2, C29.1, C31.2, R18.1, U4.3 (+)
unnamed: R14.1, R22.1, U4.1, U4.2 (-)
unnamed: C43.1, R28.2, U4.5 (+)
unnamed: C42.1, R27.2, U4.10 (+)
unnamed: C22.2, C23.1, C26.2, C28.1, C30.2, R15.1, U4.12 (+)
unnamed: R12.1, R21.1, U4.13 (-), U4.14
unnamed: R34.1, R37.1, R38.1, R41.1, U7.6 (-)
unnamed: R36.1, R39.2, R40.2, R42.1, U7.9 (-)
Out+ LM: B1.2, B2.2, B3.2, C56.1, C57.1, J13.1, J13.2, J13.3, LM1.4, R44.1, R48.1, U8.7 (EN), U8.8 (VCC), U9.7 (EN), U9.8 (VCC)
PWM gpio8: A1.11 (GPIO8), U9.3 (C)
PWM gpio9: A1.12 (GPIO9), U8.3 (C)
RESET TFT: A1.19 (GPIO14), J16.5
Rectificador biceps: J10.1 (Pin_1_1), R41.2, R47.1, U7.7
Rectificador triceps: J11.1 (Pin_1_1), R42.2, R46.2, U7.8
SCK TFT: A1.14 (GPIO10), J16.2
SCL enc: A1.7 (GPIO5), J17.5
SDA TFT: A1.15 (GPIO11), J16.3
SDA enc: A1.6 (GPIO4), J17.4
VSYS: A1.39 (VSYS), D5.1 (K)
Vo Left: J13.6, R44.2, U8.6 (VO)
Vo Right: J13.5, R48.2, U9.6 (VO)
c1: A1.26 (GPIO20), J20.5
c2: A1.27 (GPIO21), J20.6
c3: A1.29 (GPIO22), J20.7
c4: A1.1 (GPIO0), J20.8
f1: A1.21 (GPIO16), J20.1
f2: A1.22 (GPIO17), J20.2
f3: A1.24 (GPIO18), J20.3
f4: A1.25 (GPIO19), J20.4
salida pierna derecha: J12.5, R10.2
