impatrq/REDUX/Kicad/Versión_3/PCB2/PCB2_ONIET.kicad_pcb

## KiCad design Kicad/Versión_3/PCB2/PCB2_ONIET.kicad_pcb (2026-10-20)

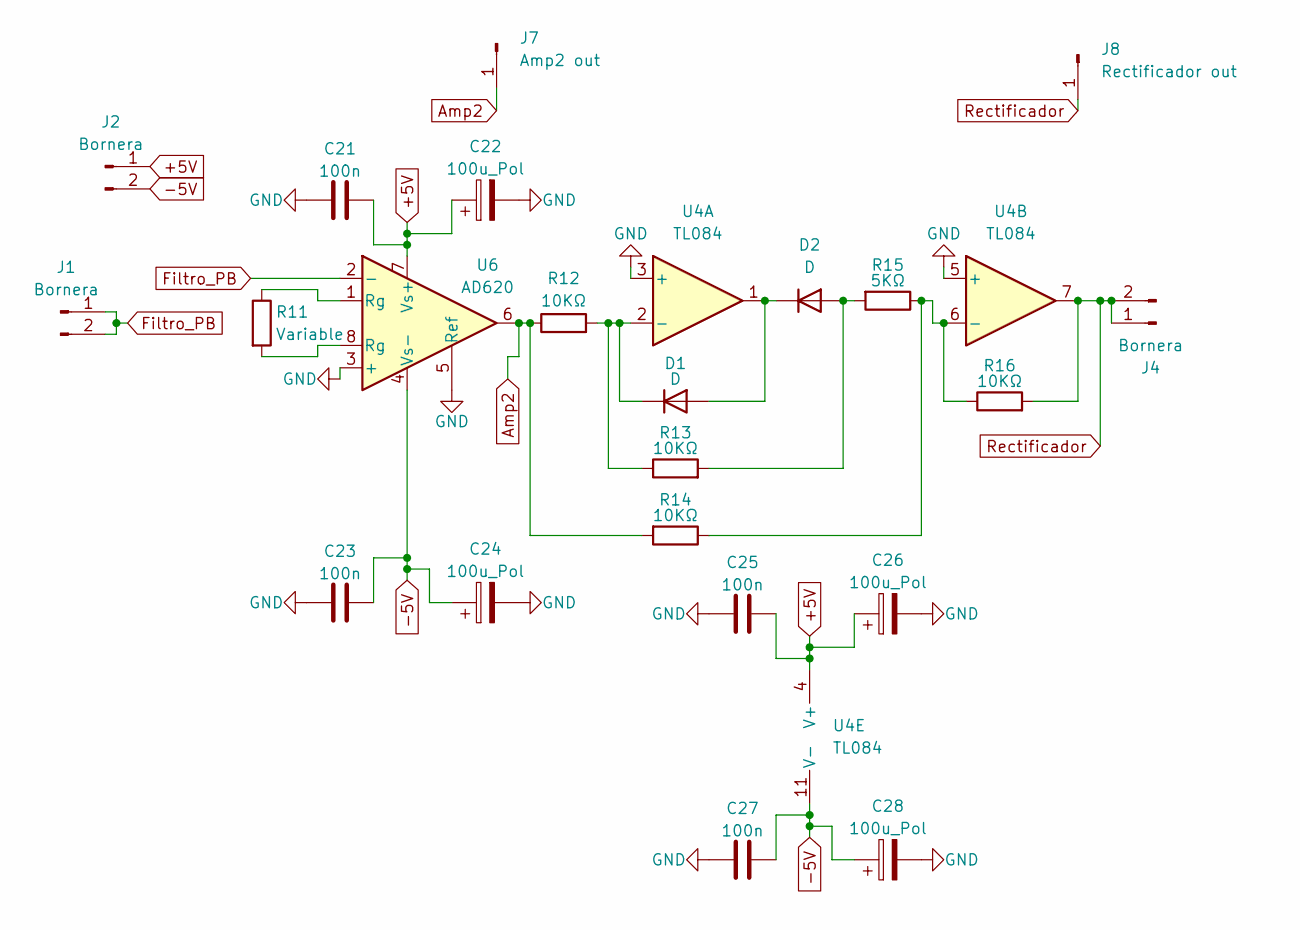
[picture p34: schematic PCB2_ONIET.kicad_sch]

Parts:
C21, C23, C25, C27: 100n; C_Disc_D10.5mm_W5.0mm_P10.00mm
C22, C24, C26, C28: 100u_Pol; C_Radial_D5.0mm_H11.0mm_P2.00mm
D1, D2: D; D_5W_P12.70mm_Horizontal
J1, J2, J4: Bornera; TerminalBlock_MetzConnect_Type011_RT05502HBLC_1x02_P5.00mm_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
J7: Amp2 out; PinHeader_1x01_P2.00mm_Vertical
J8: Rectificador out; PinHeader_1x01_P2.00mm_Vertical
R11: Variable; R_Axial_DIN0207_L6.3mm_D2.5mm_P10.16mm_Horizontal
R12, R13, R14, R16: 10KΩ; R_Axial_DIN0207_L6.3mm_D2.5mm_P10.16mm_Horizontal
R15: 5KΩ; R_Axial_DIN0207_L6.3mm_D2.5mm_P10.16mm_Horizontal
U4: TL084; DIP-14_W7.62mm_LongPads
U6: AD620; DIP-8_W7.62mm

Connections:
+5V: C21.2, C22.1, C25.2, C26.1, J2.1, U4.4 (V+), U6.7 (Vs+)
-5V: C23.2, C24.1, C27.2, C28.1, J2.2, U4.11 (V-), U6.4 (Vs-)
Amp2: J7.1 (Pin_1_1), R12.1, R14.2, U6.6
Filtro_PB: J1.1, J1.2, U6.2 (-)
GND: C21.1, C22.2, C23.1, C24.2, C25.1, C26.2, C27.1, C28.2, U4.3 (+), U4.5 (+), U6.3 (+), U6.5 (Ref)
unnamed: D1.2 (A), D2.1 (K), U4.1
unnamed: D1.1 (K), R12.2, R13.1, U4.2 (-)
unnamed: D2.2 (A), R13.2, R15.2
unnamed: R11.1, U6.1 (Rg)
unnamed: R11.2, U6.8 (Rg)
unnamed: R14.1, R15.1, R16.1, U4.6 (-)
Rectificador: J4.1, J4.2, J8.1 (Pin_1_1), R16.2, U4.7

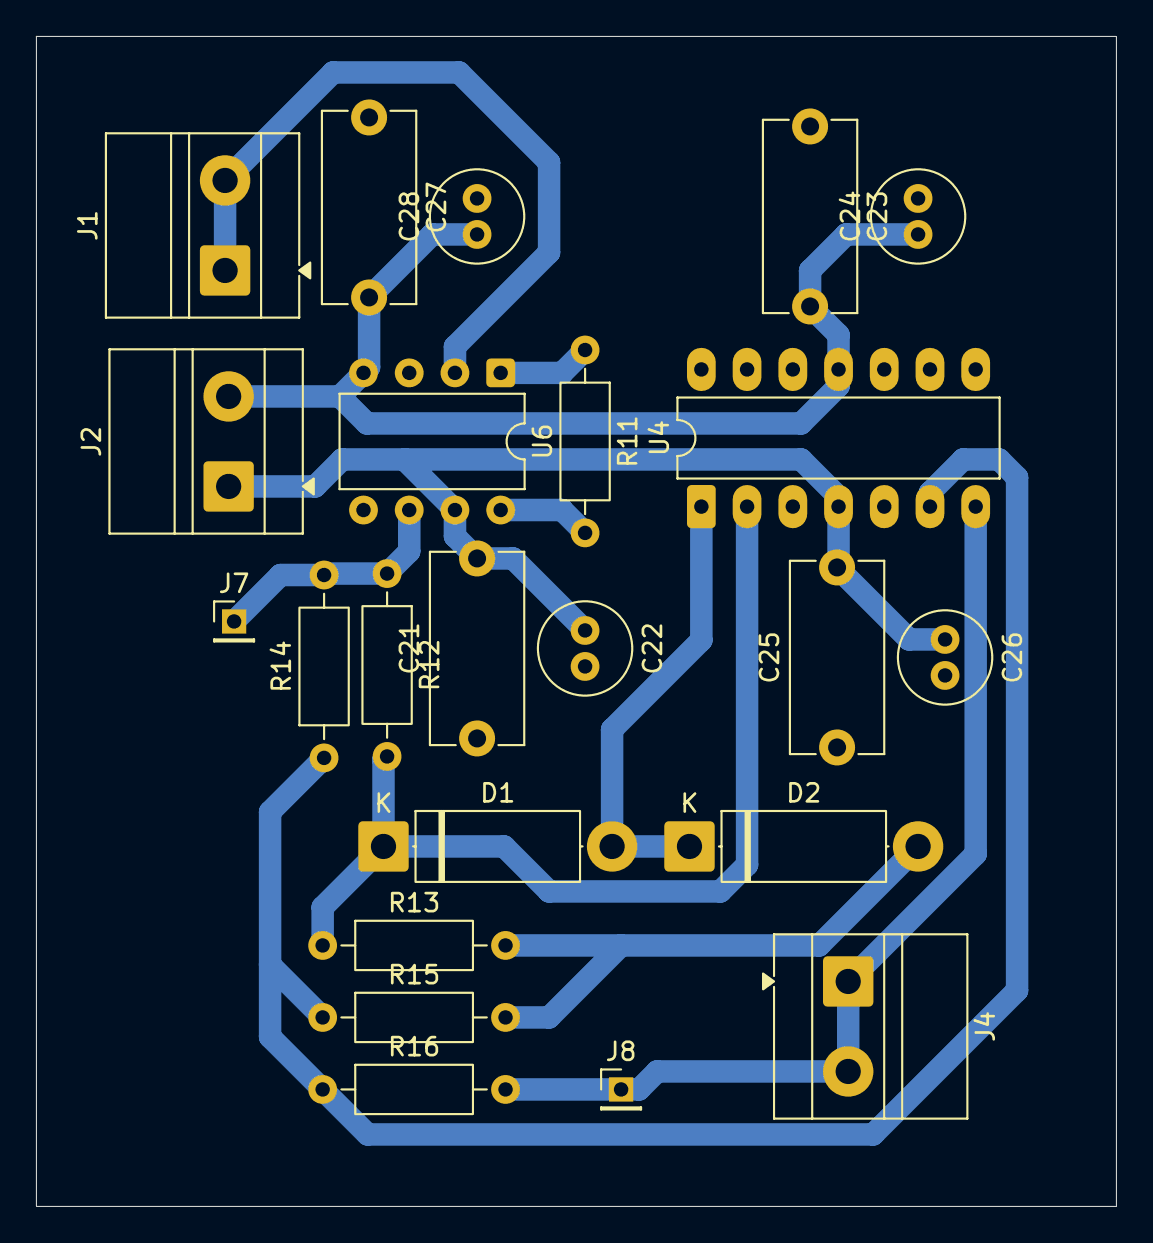
[picture p35: board PCB2_ONIET.kicad_pcb from above]

Board: 2 copper layers, 60.0 x 65.0 mm, 23 parts (0 on the bottom side), 12 nets.
