impatrq/REDUX/Kicad/Versión_3/PCB1/PCB1_ONIET.kicad_pcb

## KiCad design Kicad/Versión_3/PCB1/PCB1_ONIET.kicad_pcb (2026-10-20)

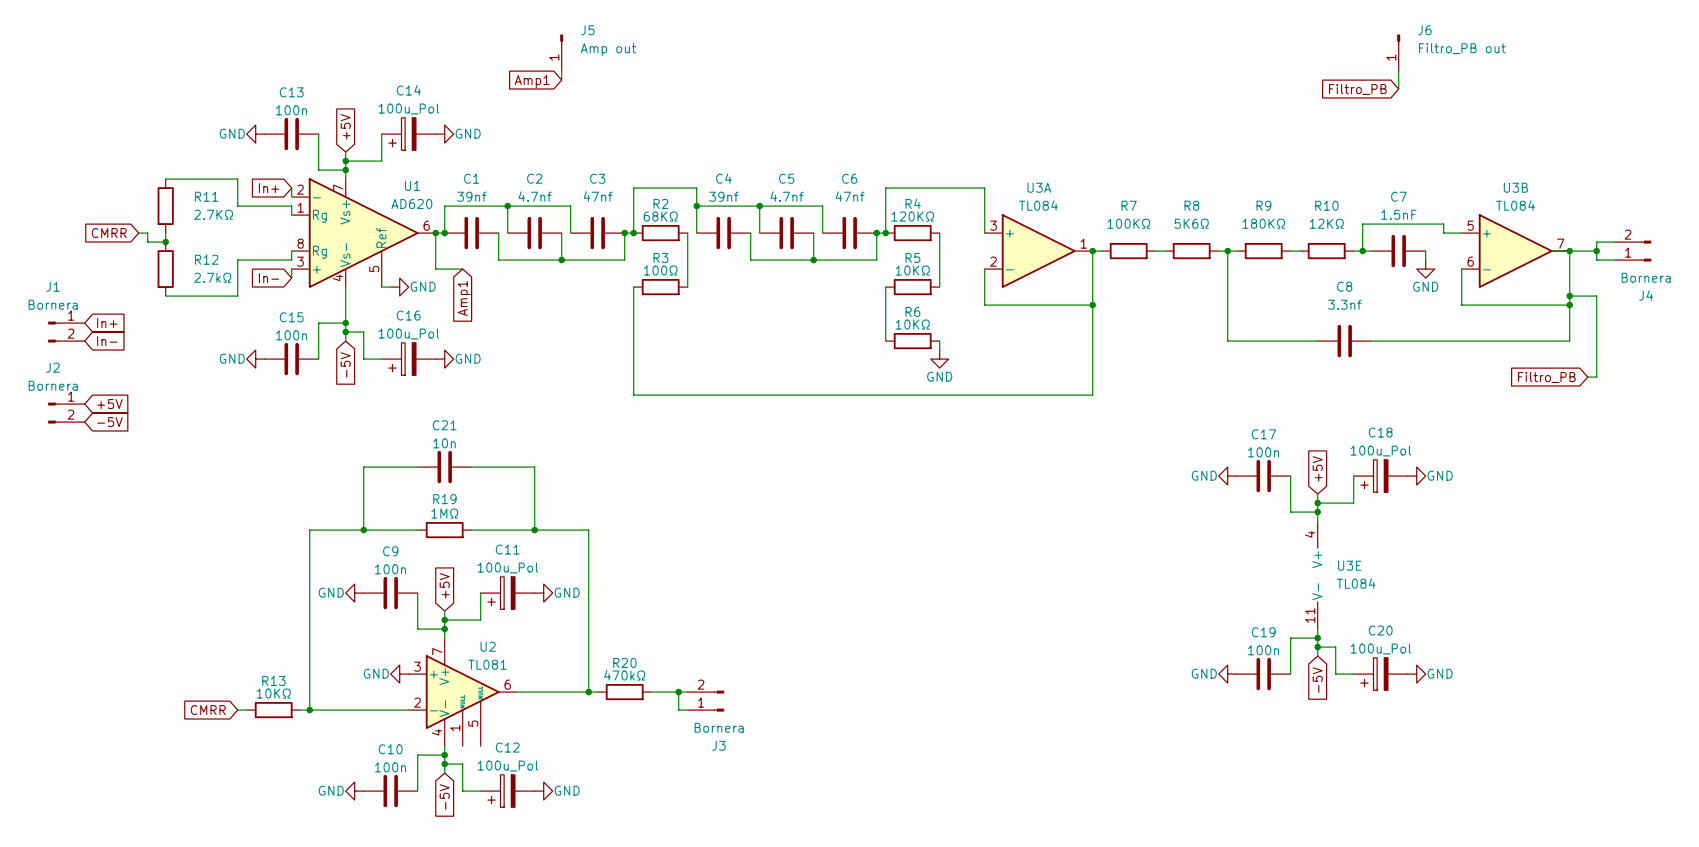
[picture p36: schematic PCB1_ONIET.kicad_sch]

Parts:
C1, C4: 39nf; C_Disc_D10.5mm_W5.0mm_P10.00mm
C2, C5: 4.7nf; C_Disc_D10.5mm_W5.0mm_P10.00mm
C3, C6: 47nf; C_Disc_D10.5mm_W5.0mm_P10.00mm
C7: 1.5nF; C_Disc_D10.5mm_W5.0mm_P10.00mm
C8: 3.3nf; C_Disc_D10.5mm_W5.0mm_P10.00mm
C9, C10, C13, C15, C17, C19: 100n; C_Disc_D10.5mm_W5.0mm_P10.00mm
C11, C12, C14, C16, C18, C20: 100u_Pol; C_Radial_D5.0mm_H11.0mm_P2.00mm
C21: 10n; C_Disc_D10.5mm_W5.0mm_P10.00mm
J1, J2, J3, J4: Bornera; TerminalBlock_MetzConnect_Type011_RT05502HBLC_1x02_P5.00mm_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
J5: Amp out; PinHeader_1x01_P2.00mm_Vertical
J6: Filtro_PB out; PinHeader_1x01_P2.00mm_Vertical
R2: 68KΩ; R_Axial_DIN0207_L6.3mm_D2.5mm_P10.16mm_Horizontal
R3: 100Ω; R_Axial_DIN0207_L6.3mm_D2.5mm_P10.16mm_Horizontal
R4: 120KΩ; R_Axial_DIN0207_L6.3mm_D2.5mm_P10.16mm_Horizontal
R5, R6, R13: 10KΩ; R_Axial_DIN0207_L6.3mm_D2.5mm_P10.16mm_Horizontal
R7: 100KΩ; R_Axial_DIN0207_L6.3mm_D2.5mm_P10.16mm_Horizontal
R8: 5K6Ω; R_Axial_DIN0207_L6.3mm_D2.5mm_P10.16mm_Horizontal
R9: 180KΩ; R_Axial_DIN0207_L6.3mm_D2.5mm_P10.16mm_Horizontal
R10: 12KΩ; R_Axial_DIN0207_L6.3mm_D2.5mm_P10.16mm_Horizontal
R11: 2.7KΩ; R_Axial_DIN0207_L6.3mm_D2.5mm_P10.16mm_Horizontal
R12: 2.7kΩ; R_Axial_DIN0207_L6.3mm_D2.5mm_P10.16mm_Horizontal
R19: 1MΩ; R_Axial_DIN0207_L6.3mm_D2.5mm_P10.16mm_Horizontal
R20: 470kΩ; R_Axial_DIN0207_L6.3mm_D2.5mm_P10.16mm_Horizontal
U1: AD620; DIP-8_W7.62mm
U2: TL081; DIP-8_W7.62mm_LongPads
U3: TL084; DIP-14_W7.62mm_LongPads

Connections:
+5V: C9.2, C11.1, C13.2, C14.1, C17.2, C18.1, J2.1, U1.7 (Vs+), U2.7 (V+), U3.4 (V+)
-5V: C10.2, C12.1, C15.2, C16.1, C19.2, C20.1, J2.2, U1.4 (Vs-), U2.4 (V-), U3.11 (V-)
Amp1: C1.1, C2.1, C3.1, J5.1 (Pin_1_1), U1.6
CMRR: R11.2, R12.1, R13.1
Filtro_PB: C8.2, J4.1, J4.2, J6.1 (Pin_1_1), U3.6 (-), U3.7
GND: C7.2, C9.1, C10.1, C11.2, C12.2, C13.1, C14.2, C15.1, C16.2, C17.1, C18.2, C19.1, C20.2, R6.2, U1.5 (Ref), U2.3 (+)
In+: J1.1, U1.2 (-)
In-: J1.2, U1.3 (+)
unnamed: C1.2, C2.2, C3.2, C4.1, C5.1, C6.1, R2.1
unnamed: C8.1, R8.2, R9.1
unnamed: C21.2, R19.2, R20.1, U2.6
unnamed: J3.1, J3.2, R20.2
unnamed: R2.2, R3.2
unnamed: R4.2, R5.2
unnamed: R5.1, R6.1
unnamed: R7.2, R8.1
unnamed: R9.2, R10.1
unnamed: R11.1, U1.1 (Rg)
unnamed: R12.2, U1.8 (Rg)
unnamed: C21.1, R13.2, R19.1, U2.2 (-)
unnamed: C4.2, C5.2, C6.2, R4.1, U3.3 (+)
unnamed: R3.1, R7.1, U3.1, U3.2 (-)
unnamed: C7.1, R10.2, U3.5 (+)

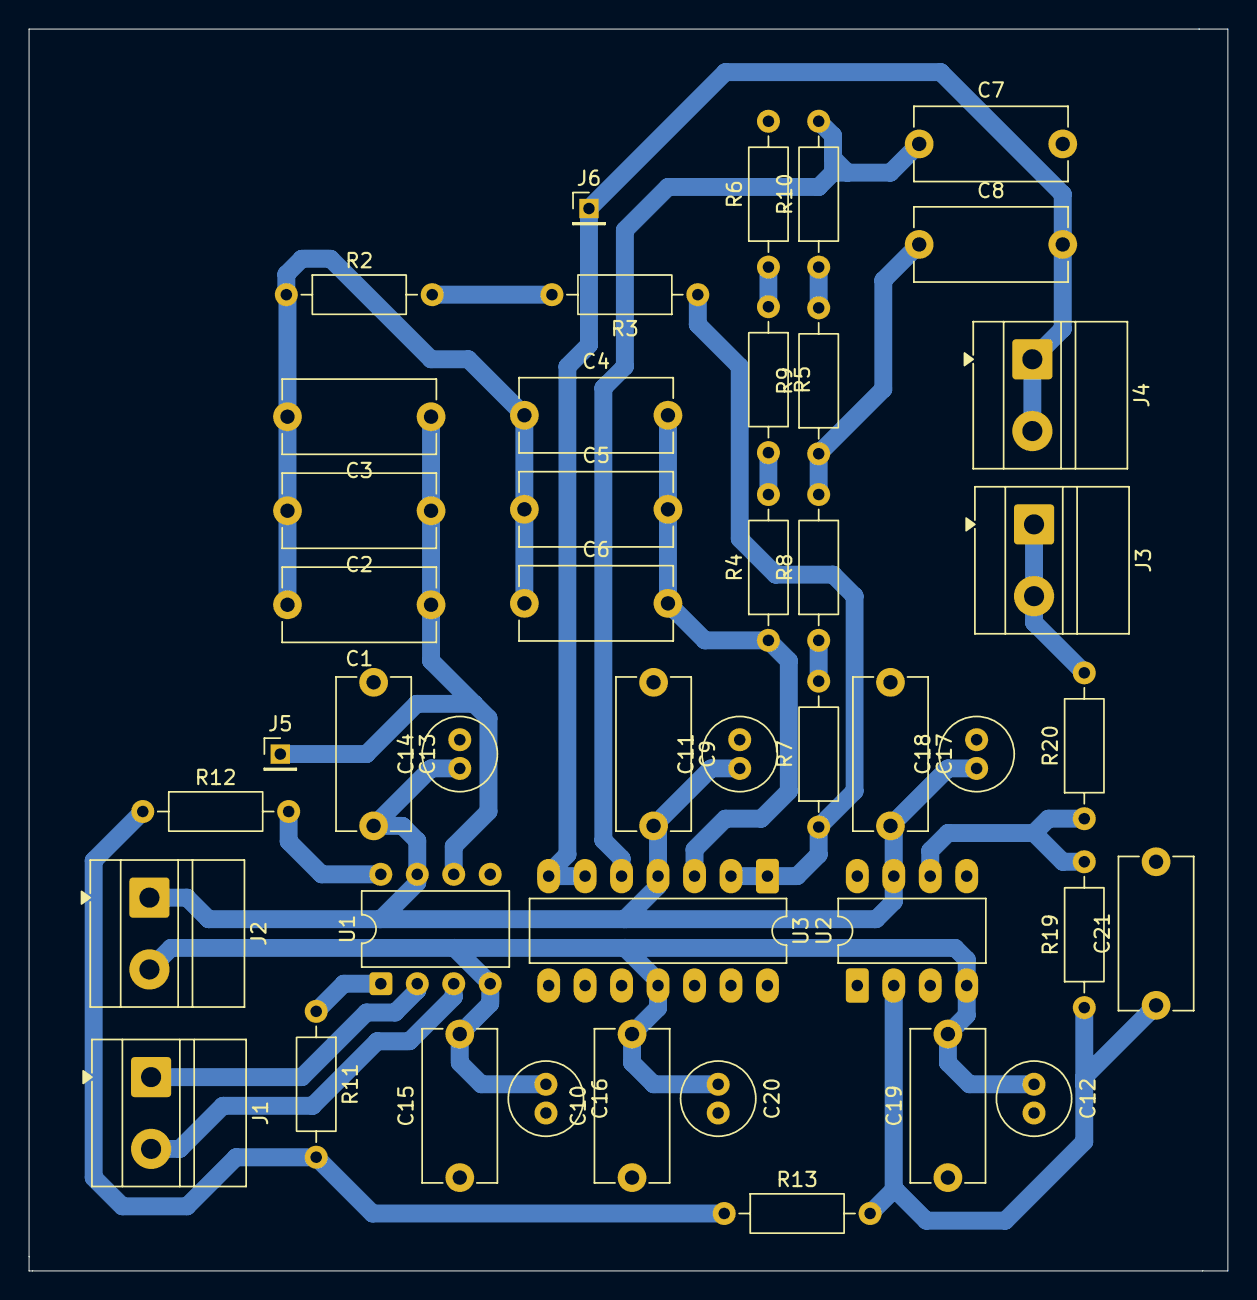
[picture p37: board PCB1_ONIET.kicad_pcb from above]

Board: 2 copper layers, 83.5 x 86.5 mm, 44 parts (0 on the bottom side), 23 nets.
