impatrq/REDUX/Kicad/Versión_1/PCB_etapa_analógica.kicad_pcb

## KiCad design Kicad/Versión_1/PCB_etapa_analógica.kicad_pcb (2026-08-31)

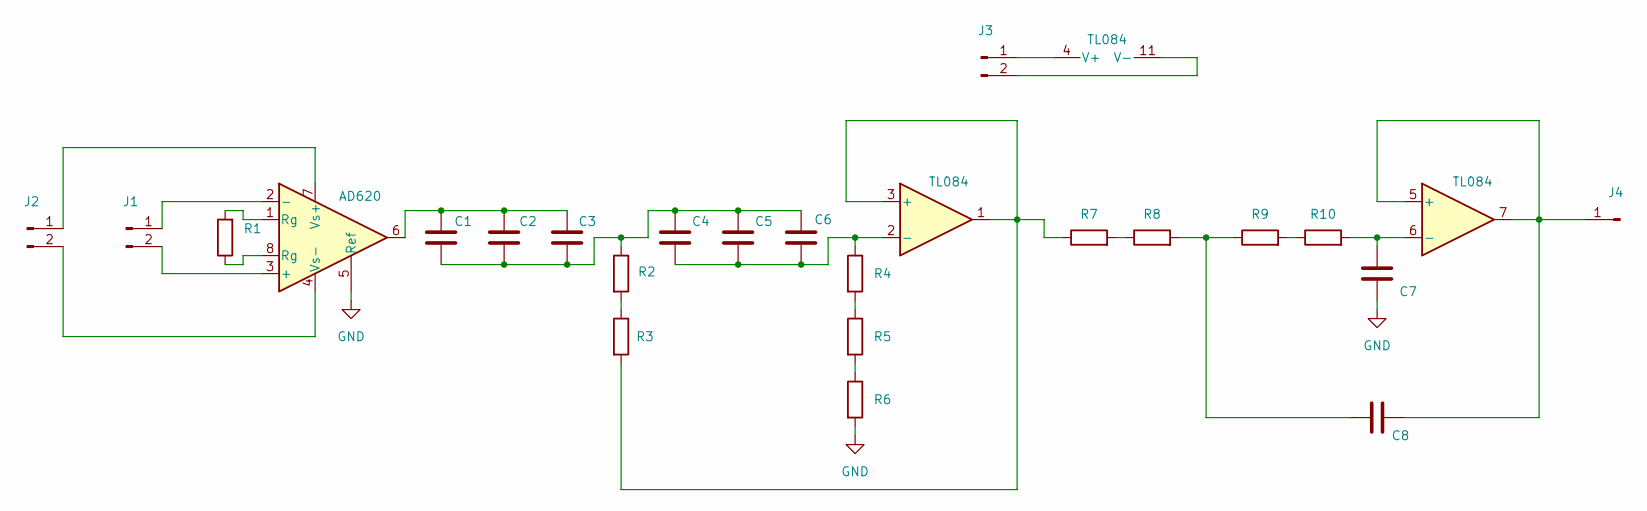
[picture p38: schematic PCB_etapa_analógica.kicad_sch]

Parts:
C1, C2, C3, C4, C5, C6, C7, C8: C; C_Disc_D6.0mm_W2.5mm_P5.00mm
J1, J2, J3: Conn_01x02_Pin; PinHeader_1x02_P2.00mm_Vertical
J4: Conn_01x01_Pin; PinHeader_1x01_P2.00mm_Vertical
R1, R2, R3, R4, R5, R6, R7, R8, R9, R10: R; R_Axial_DIN0207_L6.3mm_D2.5mm_P10.16mm_Horizontal
U1: AD620; DIP-8_W7.62mm
U2: TL084; DIP-14_W7.62mm_LongPads

Connections:
GND: C7.2, R6.2, U1.5 (Ref)
unnamed: C1.1, C2.2, C3.2, C4.2, C5.2, C6.2, R2.1
unnamed: C1.2, C2.1, C3.1, U1.6
unnamed: C8.2, R8.2, R9.1
unnamed: J1.1, U1.2 (-)
unnamed: J1.2, U1.3 (+)
unnamed: J2.1, U1.7 (Vs+)
unnamed: J2.2, U1.4 (Vs-)
unnamed: J3.1, U2.4 (V+)
unnamed: J3.2, U2.11 (V-)
unnamed: C8.1, J4.1 (Pin_1_1), U2.5 (+), U2.7
unnamed: R1.1, U1.8 (Rg)
unnamed: R1.2, U1.1 (Rg)
unnamed: R2.2, R3.1
unnamed: R4.2, R5.1
unnamed: R5.2, R6.1
unnamed: R7.2, R8.1
unnamed: R9.2, R10.1
unnamed: R3.2, R7.1, U2.1, U2.3 (+)
unnamed: C4.1, C5.1, C6.1, R4.1, U2.2 (-)
unnamed: C7.1, R10.2, U2.6 (-)

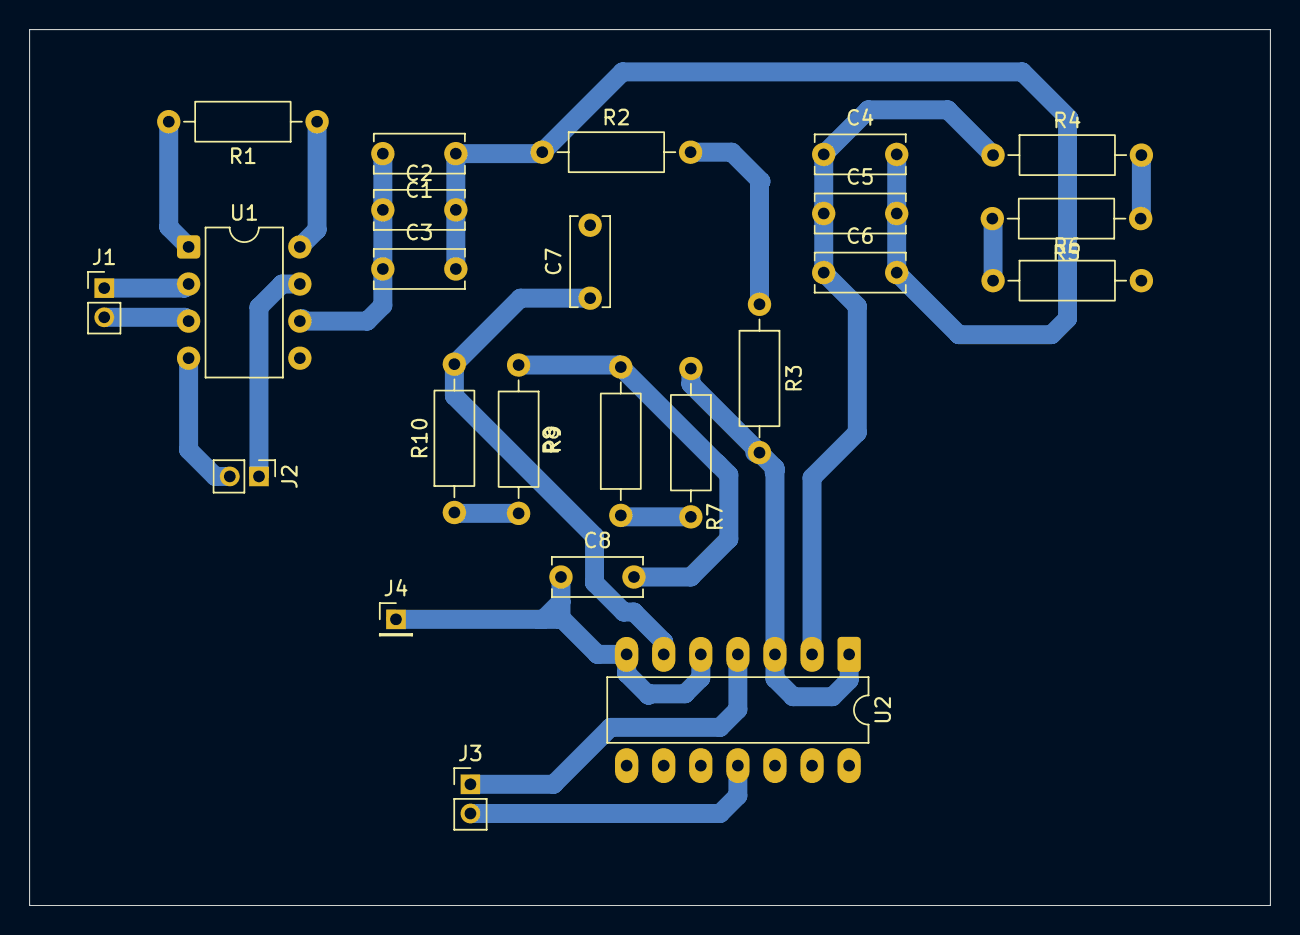
[picture p39: board PCB_etapa_analógica.kicad_pcb from above]

Board: 2 copper layers, 85.0 x 60.0 mm, 24 parts (0 on the bottom side), 21 nets.
