impatrq/REDUX/Kicad/Versión_2/Etapa de filtro pasabanda/Etapa de filtro pasabanda.kicad_pcb

## KiCad design Kicad/Versión_2/Etapa de filtro pasabanda/Etapa de filtro pasabanda.kicad_pcb (2026-08-28)

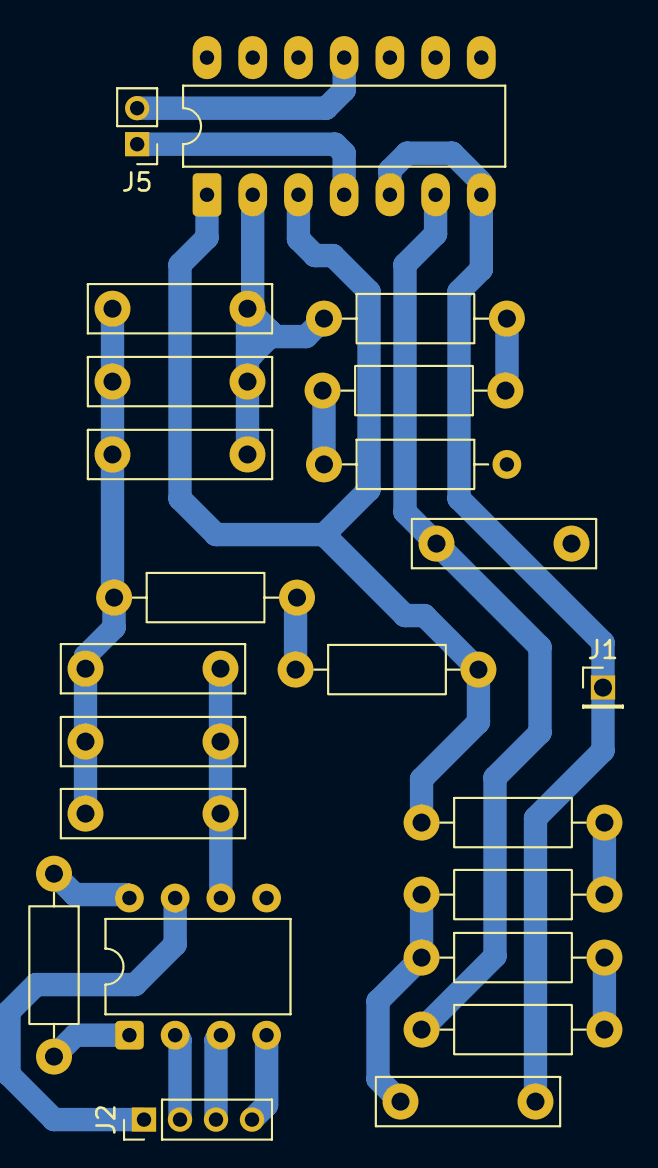
[picture p40: board Etapa de filtro pasabanda.kicad_pcb from above]

Board: 2 copper layers, 23 parts (0 on the bottom side), 21 nets.

Parts:
1.5nF, 3.3nF, 4.7nF, 4.7nF#2, 39nF, 39nF#2, 47nF#2: C; C_Rect_L10.0mm_W2.5mm_P7.50mm_MKS4
5.6kΩ, 10kΩ, 10kΩ#2, 12kΩ, 68kΩ, 100kΩ, 100Ω, 120kΩ, 180kΩ, 470Ω: R; R_Axial_DIN0207_L6.3mm_D2.5mm_P10.16mm_Horizontal
47nF: 47nf; C_Rect_L10.0mm_W2.5mm_P7.50mm_MKS4
J1: Conn_01x01_Pin; PinHeader_1x01_P2.00mm_Vertical
J2: Conn_01x04_Pin; PinHeader_1x04_P2.00mm_Vertical
J5: Conn_01x02_Pin; PinHeader_1x02_P2.00mm_Vertical
U1: AD620; DIP-8_W7.62mm
U2: TL084; DIP-14_W7.62mm_LongPads

Connections:
GND: 1.5nF.2, 10kΩ.2, U1.5 (Ref)
unnamed: 4.7nF.2, 4.7nF#2.2, 39nF.2, 39nF#2.2, 47nF.1, 47nF#2.2, 68kΩ.1
unnamed: 4.7nF#2.1, 39nF.1, 47nF.2, U1.6
unnamed: 3.3nF.2, 5.6kΩ.2, 180kΩ.1
unnamed: 3.3nF.1, J1.1 (Pin_1_1), U2.5 (+), U2.7
unnamed: J2.1, U1.7 (Vs+)
unnamed: J2.2, U1.2 (-)
unnamed: J2.3, U1.3 (+)
unnamed: J2.4, U1.4 (Vs-)
unnamed: J5.1, U2.4 (V+)
unnamed: J5.2, U2.11 (V-)
unnamed: 470Ω.1, U1.8 (Rg)
unnamed: 470Ω.2, U1.1 (Rg)
unnamed: 68kΩ.2, 100Ω.1
unnamed: 10kΩ#2.1, 120kΩ.2
unnamed: 10kΩ.1, 10kΩ#2.2
unnamed: 5.6kΩ.1, 100kΩ.2
unnamed: 12kΩ.1, 180kΩ.2
unnamed: 100kΩ.1, 100Ω.2, U2.1, U2.3 (+)
unnamed: 4.7nF.1, 39nF#2.1, 47nF#2.1, 120kΩ.1, U2.2 (-)
unnamed: 1.5nF.1, 12kΩ.2, U2.6 (-)
