impatrq/REDUX/Kicad/Versión_2/Etapa de filtro pasabajos/Etapa de filtro pasabajos.kicad_pcb

## KiCad design Kicad/Versión_2/Etapa de filtro pasabajos/Etapa de filtro pasabajos.kicad_pcb (2026-08-11)

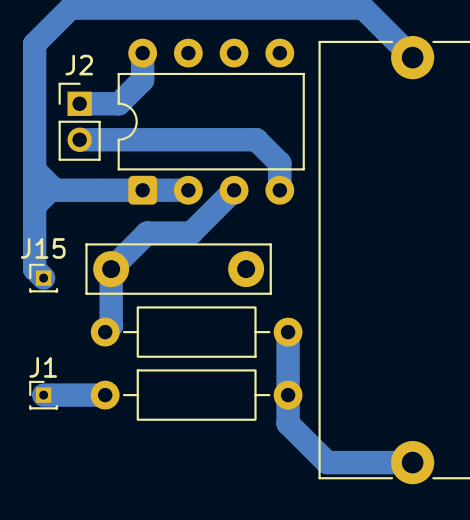
[picture p41: board Etapa de filtro pasabajos.kicad_pcb from above]

Board: 2 copper layers, 8 parts (0 on the bottom side), 6 nets.

Parts:
1.5uF: C; C_Rect_L24.0mm_W10.1mm_P22.50mm_MKT
33kΩ, 33kΩ#2: R; R_Axial_DIN0207_L6.3mm_D2.5mm_P10.16mm_Horizontal
680nF: C; C_Rect_L10.0mm_W2.5mm_P7.50mm_MKS4
J1, J15: Conn_01x01_Pin; PinHeader_1x01_P1.00mm_Vertical
J2: Conn_01x02_Pin; PinHeader_1x02_P2.00mm_Vertical
U5: TL082; DIP-8_W7.62mm

Connections:
unnamed: 1.5uF.1, 33kΩ.1, 33kΩ#2.2
unnamed: 33kΩ#2.1, J1.1 (Pin_1_1)
unnamed: J2.1, U5.8 (V+)
unnamed: J2.2, U5.4 (V-)
unnamed: 1.5uF.2, J15.1 (Pin_1_1), U5.1, U5.2 (-)
unnamed: 33kΩ.2, 680nF.1, U5.3 (+)
