impatrq/REDUX/Firmware/src/app/telemetry.h

// telemetry.h · Cola sin bloqueo entre núcleos y envío CSV por USB desde core 1.
// Depende de pico/multicore vía hal. Nunca bloquea a core 0.
#ifndef REDUX_TELEMETRY_H
#define REDUX_TELEMETRY_H

#endif // REDUX_TELEMETRY_H
