impatrq/REDUX/(commit log)

2026-04-08 Se agrega el anteproyecto
2026-04-10 Se agrega la carpeta de Documentos
2026-05-20 Feat: añado código fuente de pagina web
2026-05-20 Feat: agrego a la pagina web la pagina de contacto
2026-05-20 Docs/GS/Añado pruebas sobre el progresa sobre la estructura del proyecto.
2026-05-26 feat(circuitos): agregar diseños de filtros EMG pasa banda
    Se añaden los archivos de simulación de LTSpice (.asc) y las capturas de pantalla de estos mismos
2026-05-27 Feat: Agrego primera prueba de comunicacion
2026-05-27 feat: agregar diseño kicad filtros
    [Filtro kicap.kicad_pcb, Filtro kicap.kicad_sch]
2026-06-05 feat: Agrego prueba preliminar de la API
2026-06-10 fix: modifico esquemático corregido
    [Filtro kicap.kicad_pcb, Filtro kicap.kicad_sch, PCB_etapa_analógica.kicad_pcb, PCB_etapa_analógica.kicad_sch]
2026-08-07 feat: Kicad_version_2
    [Etapa de filtro pasabajos.kicad_pcb, Etapa de filtro pasabajos.kicad_sch, Etapa de filtro pasabanda.kicad_pcb, Etapa de filtro pasabanda.kicad_sch, Etapa de rectificación de presición.kicad_pcb, Etapa de rectificación de presición.kicad_sch]
2026-08-11 Fix: valores kicad
    [Etapa de filtro pasabajos.kicad_pcb, Etapa de filtro pasabanda.kicad_pcb, Etapa de rectificación de presición.kicad_pcb]
2026-08-28 feat(modelos): Añado modelo final de la ortesis
    [PCB_etapa_analógica.kicad_pcb, PCB_etapa_analógica.kicad_sch]
2026-09-02 feat: Esquematico-circuito
2026-10-01 chore(fase-0): esqueleto de carpetas, build y convenciones
    - Estructura de src/ (common, hal, sensors, actuators, control, app),
    tests/ y tools/ con placeholders y su comentario de rol.
    - Entry point en src/main.c (banner de version por USB); LED a Fase 1.
    - CMakeLists adaptado: USB stdio, include dirs por capa y flags estrictas
    (-Wall -Wextra -Werror -Wshadow -Wconversion) solo sobre fuentes propias.
    - CLAUDE.md, README.md, .clang-format y .gitignore.
2026-10-02 feat(hal): implementar config, tipos y HAL de la Fase 1
    - common: redux_types (direction/intent/sys_state/fault/status), util
    (clampf/mapf/slewf) y config con las constantes de la fase.
    - board.h refleja la tabla "Pinout definitivo"; pines de Fase 9 solo
    documentados, sin inicializar.
    - hal_time (tick de 1 ms por repeating_timer, ISR solo levanta bandera),
    hal_adc, hal_pwm, hal_i2c (timeout -> status_t), hal_gpio (R_EN/L_EN en
    bajo), hal_wdt (sin habilitar aun) y hal_button (GP3, pull-up, activo en
    bajo, antirrebote no bloqueante, avisa una vez por pulsacion).
    - main.c: parpadeo del LED gobernado por el tick; el motor no se activa.
    - diag/fase1_check: programa de prueba (target apa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
2026-10-02 feat(hal): agregar hal_gpio_motor_enable para el BTS7960
    Expone el control de R_EN/L_EN (ambos juntos) que necesita el driver del
    puente H, ya que solo hal/ puede tocar el GPIO. Agregado aditivo sobre la
    Fase 1; hal_gpio_init sigue dejando los enable en bajo al arranque.
2026-10-02 feat(bts7960): driver del puente H con pruebas en PC
    Implementa bts7960_init/enable/stop/apply usando solo hal_pwm y hal_gpio.
    apply recorta el duty a DUTY_MAX y siempre pone a 0 el lado opuesto antes
    de escribir el activo, garantizando que nunca haya PWM > 0 en RPWM y LPWM
    a la vez. init arranca deshabilitado y con duty 0.
    Agrega DUTY_MAX a config.h. Vendoriza Unity (v2.x) en tests/unity y arma
    tests/CMakeLists.txt como proyecto nativo de PC (sin SDK) con mocks de
    hal_pwm/hal_gpio que registran cada escritura. test_bts7960 cubre el
    invariante en una secuencia larga aleatoria, el recorte a DUTY_MAX, el
    orden apagar-opuesto-primero, stop e init.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
2026-10-02 feat(diag): programa de banco fase2_check del BTS7960
    Ejecutable aparte que maneja el driver con el motor sin carga por el
    monitor serie: f N / e N / s / en 1 / en 0. Limita N a FASE2_DUTY_MAX_PCT
    (50 %), frena y espera FASE2_REVERSE_BRAKE_MS (200 ms) antes de invertir
    el sentido, y aplica un hombre muerto de FASE2_DEADMAN_MS (5 s) que frena
    solo si no llegan comandos. Imprime el estado tras cada comando.
    Agrega el target fase2_check y suma bts7960.c a las fuentes con flags
    estrictas del firmware.
2026-10-02 Feat: Agrego archios del soporte del motor
    [Soporte_motor.dwg, Soporte_motor.stl]
2026-10-02 Feat: Agrego archivos del soporte de pantalla y teclado
    [Soporte_pantalla.dwg, Soporte_pantalla.stl]
2026-10-03 feat(sensors): driver AS5600 y calibración del rango del paciente (Fase 3)
    Driver AS5600 (RAW ANGLE, STATUS MD/ML/MH, wrap_diff puro y lectura
    promediada no bloqueante de a una muestra por tick), calibración del rango
    rom_calib accionada por eventos de ui, interfaz ui.h + ui_basic (pulsador,
    LED, USB) y programa de banco fase3_check. El driver del motor queda
    deshabilitado en toda la fase.
    ui_event_t vive en redux_types.h para que las dependencias solo bajen.
    Constantes nuevas en config.h con unidad. Pruebas en PC con Unity y un
    mock de I2C: test_as5600 y test_rom_calib.
    código y pruebas en PC OK, validación en hardware pendiente (el módulo
    AS5600 se dañó: pista de SDA levantada).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
2026-10-03 feat(control): lógica pura de intención, límites y potencia (Fase 5)
    Implementa la capa control/ (lógica pura, sin hal ni SDK ni estado global):
    - intent_decide: tabla XOR (REST/FLEX/EXT/COCONTRACTION).
    - limits_factor: factor 0..1 con bloqueo y zona de freno; fuera de rango
    solo deja volver hacia adentro.
    - limits_must_stop: corte inmediato cuando el sentido aplicado alcanza o
    pasa su límite (regla de seguridad 3).
    - power_target: duty desde intensidad y factor (factor<=0 => 0, no DUTY_MIN);
    power_step: rampas por tick y frenado a 0 antes de invertir el sentido.
    config.h: DUTY_MIN, BRAKE_ZONE_DEG, RAMP_UP_PER_S, RAMP_DOWN_PER_S y
    _Static_assert(DUTY_MIN < DUTY_MAX).
    Pruebas en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
2026-10-05 fix(hal): pinout definitivo de la PCB (enables fijos, 6N137, dos masas)
    En la PCB R_EN/L_EN del BTS7960 van fijos a +5 V del lado del motor, así
    que GP6 y GP7 quedan libres y el firmware ya no maneja ningún enable: el
    control del motor es solo por RPWM/LPWM (vía optoacopladores 6N137 que no
    invierten). También quedan libres GP15 (luz de fondo fija a 3V3) y GP28.
    GP2/GP3 pasan a ser solo de desarrollo.
    - board.h: refleja la tabla "Pinout definitivo"; elimina PIN_MOTOR_L_EN/
    R_EN, PIN_TFT_BL, PIN_MOTOR_IS/ADC_CH_MOTOR_IS; documenta libres y pines
    de solo desarrollo; nota EMG rectificada 0–3 V y 6N137 en RPWM/LPWM.
    - hal_gpio: hal_gpio_init y hal_gpio_motor_enable pasan a no-op (enab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
2026-10-05 feat(emg): canal EMG, calibración y banco fase4_check (Fase 4)
    Canal EMG como lógica pura con estado en emg_channel_t que pasa el
    llamador (sin globales): rectificado opcional segun EMG_RAW_SIGNAL,
    envolvente exponencial con alpha derivado de EMG_ENV_CUTOFF_HZ y el
    tick, histéresis con tiempo mínimo EMG_ON_MIN_MS, intensidad acotada
    0-1 y detección de saturación.
    emg_calib no bloqueante, un emg_calib_t por canal (mvc_begin recibe el
    canal): reposo -> media/desvío -> umbrales (ruido alto = error) y MVC
    con env_at_max = media + EMG_MVC_USE*(pico-media), débil si
    (pico-media) < EMG_MVC_MIN_RATIO*(thr_on-media) y garantizando
    env_at_max > thr_on.
    El sobremuestreo EMG_OVERSAMPLE por can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
2026-10-05 chore(tests): correr las pruebas de PC en WSL
    Smart App Control (Enforced) bloquea los .exe de prueba de MinGW en Windows.
    Se agrega tools/run_tests_wsl.ps1 para compilar y correr las pruebas dentro de
    WSL 2 (build separado en build-tests-wsl/, ignorado) con un solo comando, y se
    documenta como la forma oficial en CLAUDE.md.
2026-10-05 fix(emg): corregir test del pico corto y cubrir artefacto por saturación
    test_short_spike_does_not_activate usaba un pico enorme (4000 counts). El conteo
    de activación corre sobre la envolvente (la señal real llega rectificada y sin
    suavizar), así que ese pico dejaba la envolvente sobre el umbral durante su
    decaimiento más de EMG_ON_MIN_MS y activaba el canal. El test ahora usa un pico
    corto de amplitud moderada que cruza thr_on por poco y verifica que EMG_ON_MIN_MS
    lo filtra.
    Se agrega test_huge_artifact_flagged_by_saturation: un artefacto enorme y breve no
    activa, y uno sostenido se rechaza por saturación (no por la lógica de intención).
    Se anota en docs/PLAN.md (Fase 8) que este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
2026-10-06 feat(diag): mostrar la lectura cruda del AS5600 durante la calibración
    fase3_check imprime RAW, grados crudos y MD/ML/MH cada 200 ms mientras la
    calibración espera una confirmación (flexión o extensión máxima), igual que
    en el modo raw, para ubicar el imán antes de confirmar.
    Validado en hardware con el AS5600 nuevo: lectura estable con el imán quieto,
    θ continuo cruzando el 0, sentido detectado en ambas direcciones y
    calibraciones inválidas rechazadas.
2026-10-06 feat(supervisor): máquina de estados de seguridad
    Máquina de estados pura (estado en supervisor_t, probada en PC): BOOT,
    CHECK_ENC, CALIB_ROM/REST/MVC, ARMING, RUN, FAULT. El motor solo se mueve en
    RUN (motor_allowed == (state==RUN)). Orden de decisión por tick: fallas de
    seguridad, eventos de ui, progresión. Co-contracción y límite no cambian el
    estado (los corta la cadena); saturación de EMG en marcha da FAULT_EMG_SAT.
    Dos rutas de rearme tras REARM_OK_TICKS estables: FAULT_ENC_MASK -> CALIB_ROM,
    el resto -> ARMING. Detector de salto de ángulo (angle_watch) que reinicia su
    referencia al entrar a ARMING/RUN. ANGLE_JUMP_MAX_DEG 30 -> 5 grados.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
2026-10-06 feat(app): integración del ciclo y watchdog
    app_tick() corre un ciclo en el orden fijo del plan: watchdog, EMG (sobremuestreo
    real o fuente simulada por serie según EMG_SOURCE), encoder (ángulo, imán cada
    MAGNET_CHECK_TICKS, salto de ángulo solo en estados armados), supervisor, y la
    cadena intent -> limits -> power -> bts7960, con corte (bts7960_stop) fuera de RUN.
    Mide el tiempo del ciclo y suma los ticks perdidos como sobrepaso. Habilita el
    watchdog una sola vez al armar (flag en el struct). Recorta el duty a DUTY_CEIL
    (DUTY_MAX_BENCH en banco). En EMG_SOURCE_SERIAL la calib de EMG se autocompleta y
    queda marcada como simulada. El firmware integra app/ y control/ y baja el timeout
    de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
2026-10-06 feat(app): firmware con ui y reporte USB
    main.c: inicializa el SDK y los módulos, arranca ui_basic (pulsador/LED/serie) y
    corre el lazo por tick llamando a app_tick (que detecta ticks perdidos). Lee líneas
    de serie no bloqueantes y las enruta a la fuente de EMG simulada ("b N"/"t N"/"r")
    o a la interfaz ("ok"/"cancel"/"recal"). Reporta el estado por USB cada 100 ms fuera
    de la medición del ciclo de control: arma la línea en un buffer y la drena de a
    chunks con putchar_raw, e informa su propia duración (trep). La telemetría completa
    en core 1 es de la Fase 7.
2026-10-06 test(supervisor): transiciones, rearme y fallas
    Pruebas Unity del supervisor (lógica pura) y de la cadena de control en marcha:
    secuencia completa BOOT->RUN; enc_fault en CALIB_ROM/REST/MVC; RECALIBRATE desde
    RUN; CANCEL en calibración y en RUN; FAULT_OVERRUN con 3 sobrepasos seguidos (y 2
    que no alcanzan, con reset); rearme por FAULT_ENC -> CALIB_ROM y por OVERRUN ->
    ARMING sin perder la calibración; rearme que exige reposo; FAULT_EMG_SAT en marcha;
    motor_allowed nunca fuera de RUN; integración supervisor+intent+limits+power para
    co-contracción y límite (sigue en RUN, corta la cadena); y el detector de ángulo.
2026-10-06 test(diag): comando hang para probar watchdog
    Comando de serie "hang" (solo con BENCH_MODE): avisa por USB y cuelga el lazo en un
    bucle sin alimentar el watchdog, para verificar en banco que la Pico se reinicia tras
    ~WDT_TIMEOUT_MS cuando está armada. Diagnóstico temporal; quitar antes de la versión
    final.
2026-10-06 fix(app): mostrar raw del encoder en el reporte
    Durante CALIB_ROM el reporte mostraba th=0.0 fijo (sin calibrar), así
    que no se veía si el encoder respondía. Se agrega el campo raw= con la
    lectura cruda del AS5600, siempre visible, igual que en fase3_check.
2026-10-06 fix(app): inicializar el PWM del motor y reportar el duty aplicado
    En RUN el motor no sacaba PWM (GP8/GP9 en 0 V) aunque el reporte mostrara duty>0:
    app_init no llamaba a bts7960_init, así que los slices de PWM (slice 4, 20 kHz)
    nunca se configuraban y bts7960_apply escribía a un PWM apagado. fase2_check sí lo
    inicializa, por eso ahí andaba con el mismo hardware. Se agrega bts7960_init() en
    app_init.
    Además el reporte mostraba g_ps.duty (el objetivo de la rampa), no lo realmente
    escrito al PWM. bts7960 ahora recuerda el último duty escrito por lado y expone
    bts7960_applied(dir, duty); el reporte usa eso y agrega pwm=R/L/0, de modo que el
    duty del reporte coincide con lo que mide un os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
2026-10-06 chore(tools): generar uf2 por WSL
    Device Guard / SAC bloquea picotool.exe (el empaquetado del build de Windows),
    aunque el .elf enlaza bien. tools/make_uf2_wsl.ps1 compila un picotool nativo de
    Linux en WSL una sola vez (en ~/.local/bin, no en el repo) usando como PICO_SDK_PATH
    el SDK ya instalado en Windows, y convierte build/redux-firmware.elf a .uf2 con la
    familia rp2350-arm-s, sin tocar la configuracion de Windows. Al terminar imprime
    'picotool info' del .uf2. Verificado: target chip RP2350, image type ARM Secure,
    name redux-firmware, version 0.6. Documentado en README.md.
2026-10-20 feat: agrego PCB ONIET
2026-10-21 chore(entregas): zips por fase, índice y script
    Un zip por fase (código, pruebas y diagnóstico) con su LEEME.md, más
    entregas/README.md y tools/make_entregas.ps1 para regenerarlos. Los zips
    quedan en .gitignore. Tags locales fase-0..fase-6 en el cierre de cada fase.
2026-10-22 feat: agrego PCB alimentación
2026-10-28 refactor(estructura): separar firmware y pruebas para el repo del equipo
    src/ queda solo con el firmware real (se va src/diag/). Los programas de
    banco pasan a Pruebas/banco/<fase>/ con un README cada uno (fase1_hal,
    fase2_motor, fase3_encoder y emg, antes fase4_check -> emg_check). Las
    pruebas de PC y run_tests_wsl.ps1 van a Pruebas/unitarias/; telemetry_plot.py
    a Pruebas/. Todo movido con git mv para conservar el historial.
    - CMakeLists raiz: rutas nuevas, target fase4_check -> emg_check y opcion
    REDUX_BUILD_BANCOS (ON) para compilar el firmware sin los bancos.
    - Pruebas/unitarias/CMakeLists.txt y run_tests_wsl.ps1: raiz dos niveles
    arriba y -S Pruebas/unitarias.
    - make_entregas.ps1 a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
2026-11-04 Feat: Agrego codigo referido a la interfaz
2026-11-04 feat: agrego versión 4 del PCB
2026-11-05 fix: se optimiza el PCB
2026-11-13 Fix: Cambio del modelo del soporte para el motor
2026-11-13 Feat: Agrego imagen del soporte de pantalla
2026-11-13 Feat: Se agregan los archivos del Reel para motor
2026-11-13 Feat: Agrego archivos de la caja
